AMPrO-3D/Roboterarm/Warenkorb/README.md

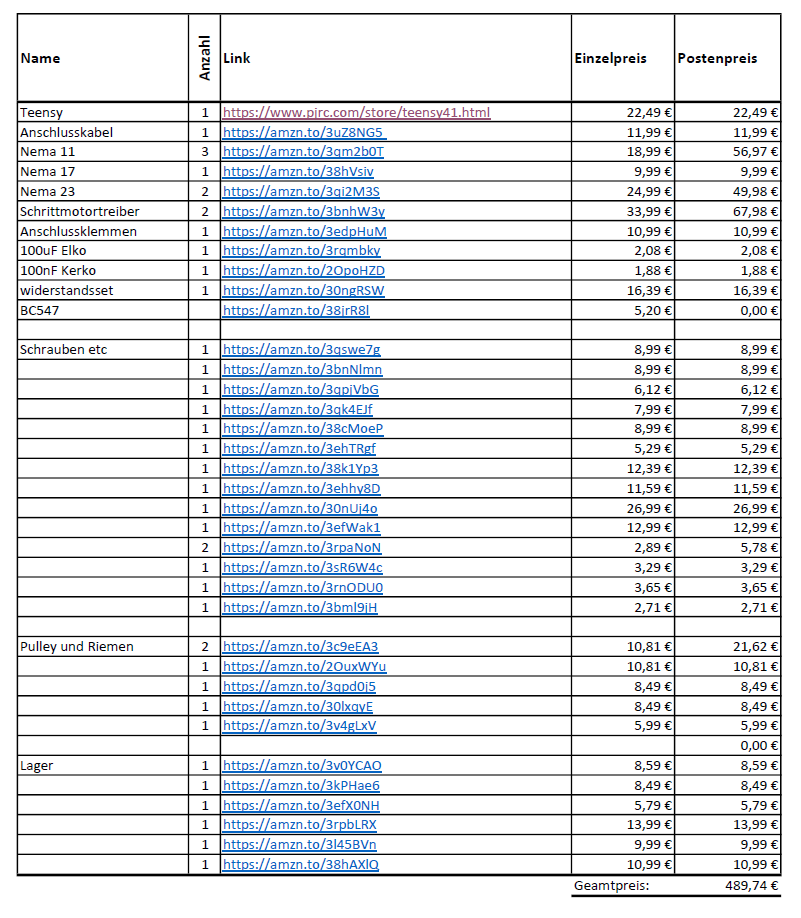
[picture p7: blob/Bilder/Warenkorb.PNG]
Board Preview
