AMPrO-3D/Roboterarm/Elektronik/README.md

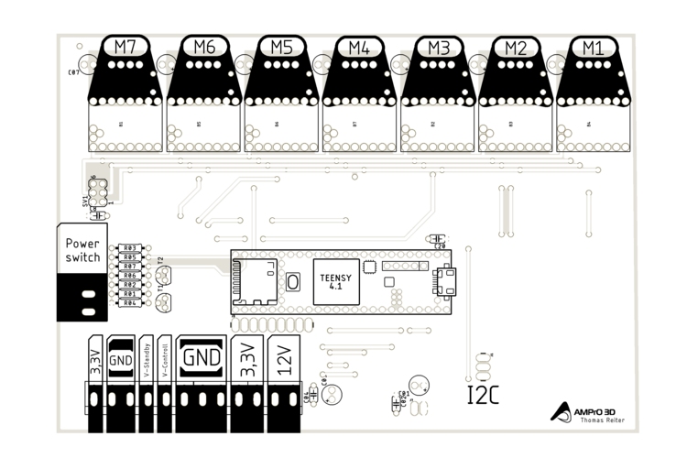
[picture p8: blob/Bilder/MainBoard.png]
Board Preview

Board Preview
