AMPrO-3D/Roboterarm/Firmware/README.md

# HowTo
<hr>

Um die Firmware auf den Teensy zu Flashen, wird zum einen die Arduino IDE benötigt, die unter folgendem Link heruntergeladen werden kann: <br>
https://www.arduino.cc/en/software <br>
sowie das Addon Teensyduino, welches über folgende Webseite heruntergeladen und installiert werden kann: <br>
https://www.pjrc.com/teensy/teensyduino.html

### Als Erstes lädt man die Firmware in die Arduino Entwicklungsumgebung.
### Anschließend muss über "Werkzeuge" unter "Board" die Option "Teensy 4.1" ausgewählt werden

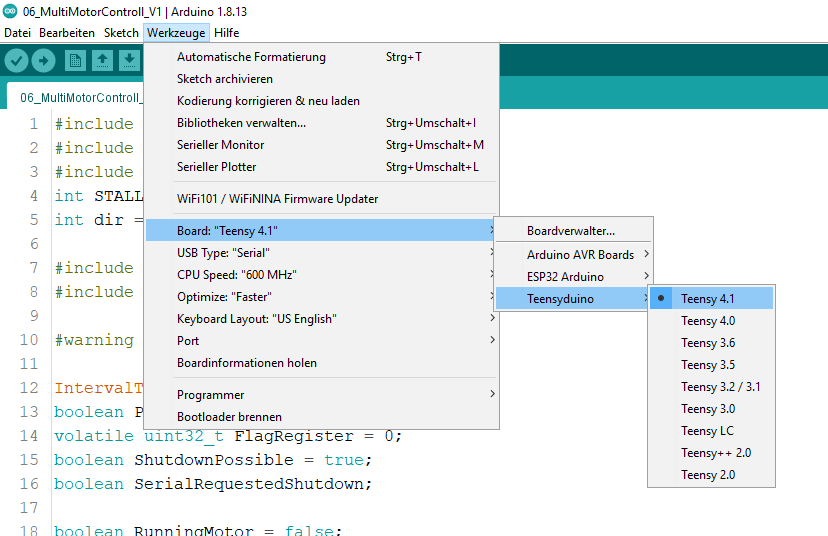
[picture p9: blob/Bilder/ArduinoIDEA1.png]
Arduino Settings
⋅⋅⋅
<br>
<br>
<br>
<br>
### Wenn man nun über "Werkzeuge" unter "Port" den Eintrag auswählt der mit "Serial (Teensy 4.1)" endet

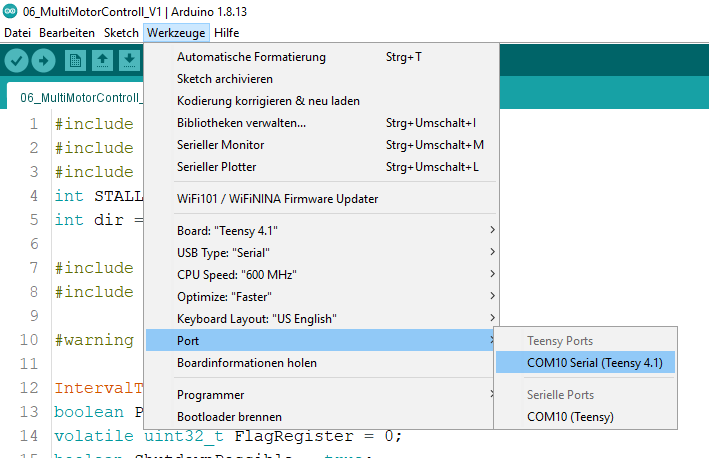
[picture p10: blob/Bilder/ArduinoIDEA2.png]
Arduino Settings
⋅⋅⋅
<br>
<br>
<br>
<br>
### kann man über "Sketch" auf "Hochladen" klicken, um die Firmware auf den Teensy zu flashen

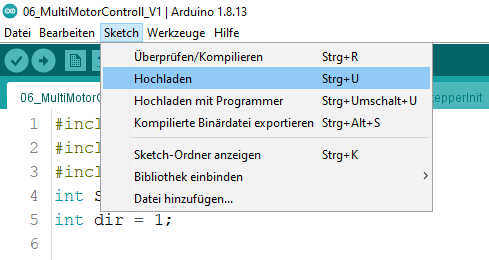
[picture p11: blob/Bilder/ArduinoIDEA3.png]
Arduino Settings
⋅⋅⋅
