AMPrO-3D/Roboterarm/Zusatzteile/Greifer/README.md

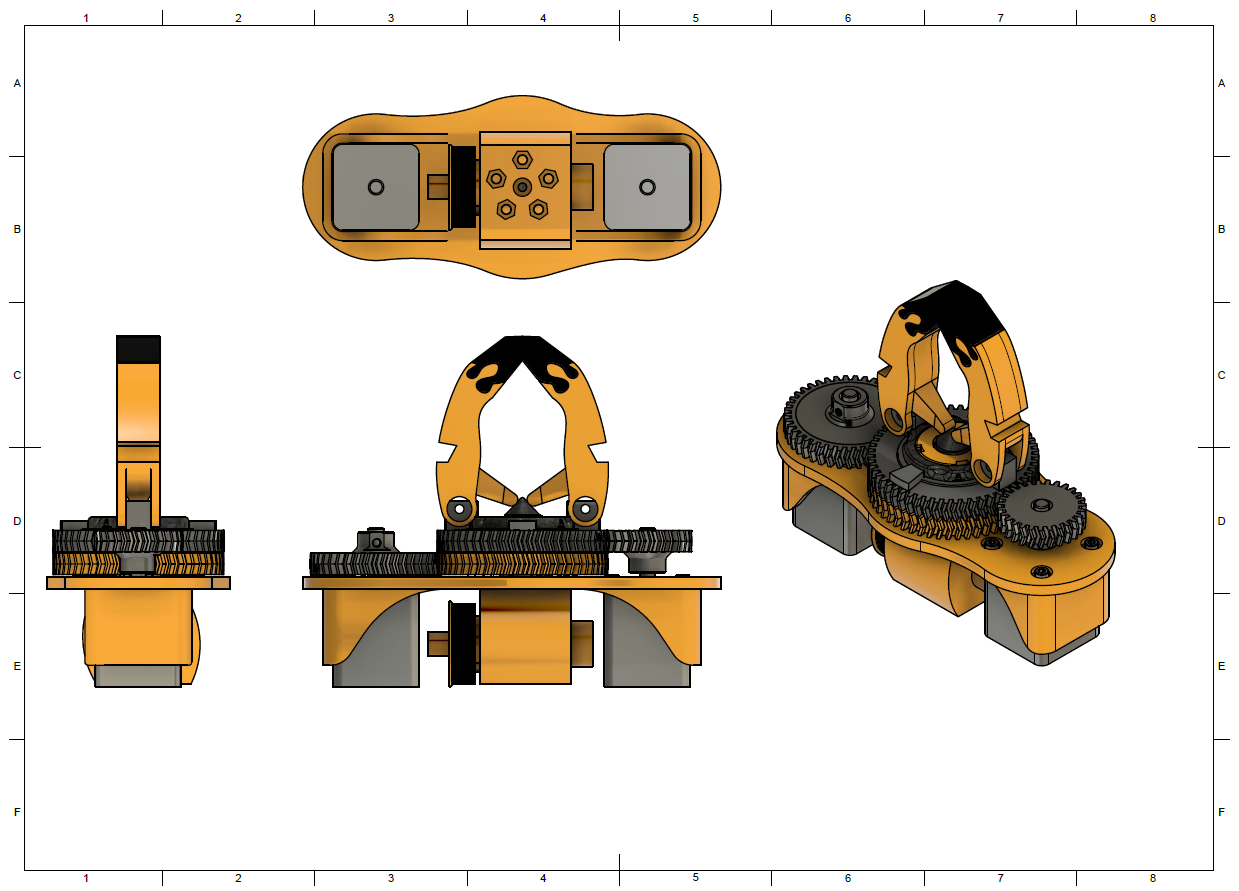
[picture p12: blob/Bilder/GreiferB1.PNG]
Greifer Preview

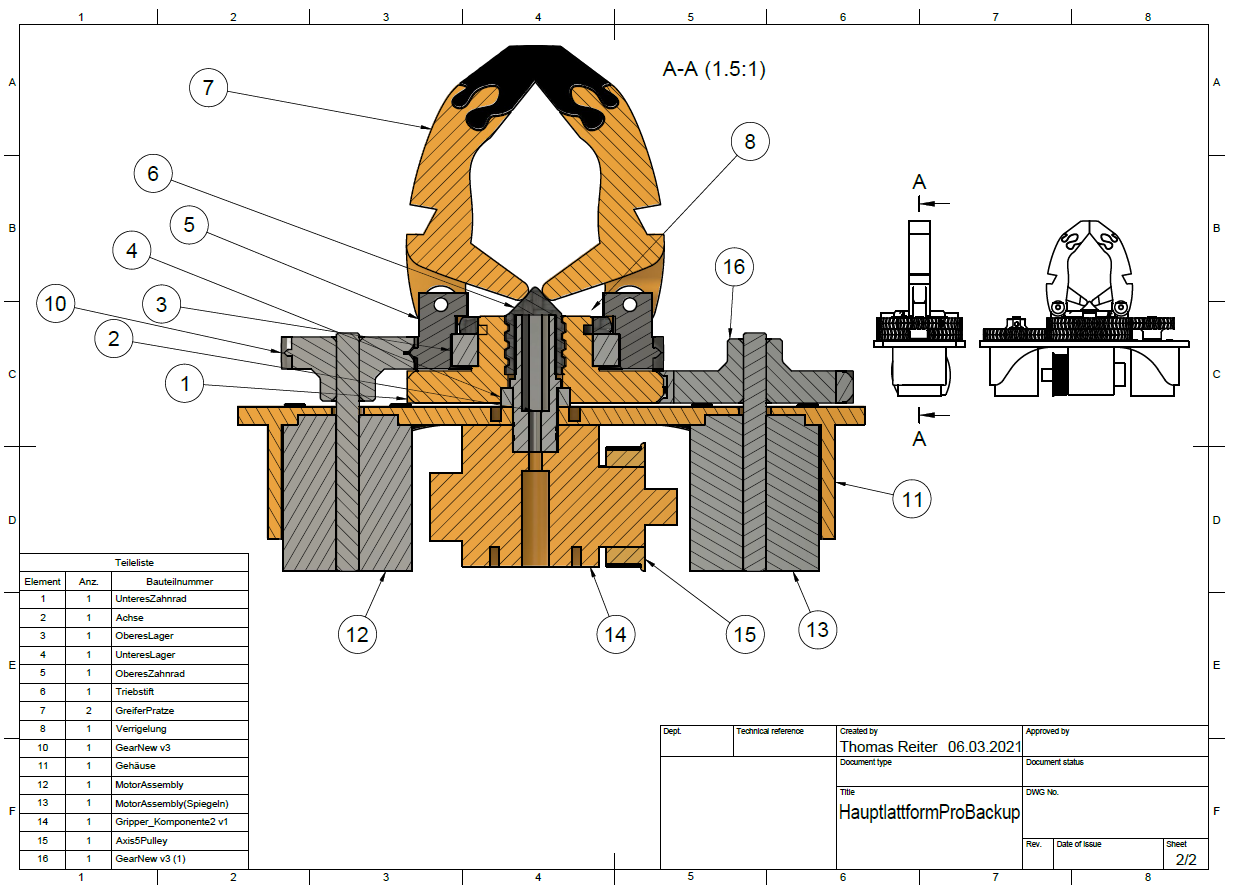
[picture p13: blob/Bilder/GreiferB2.PNG]
Greifer Preview
