AMPrO-3D/Roboterarm/Zusatzteile/Axis1Pulley_OpenLoop.stl

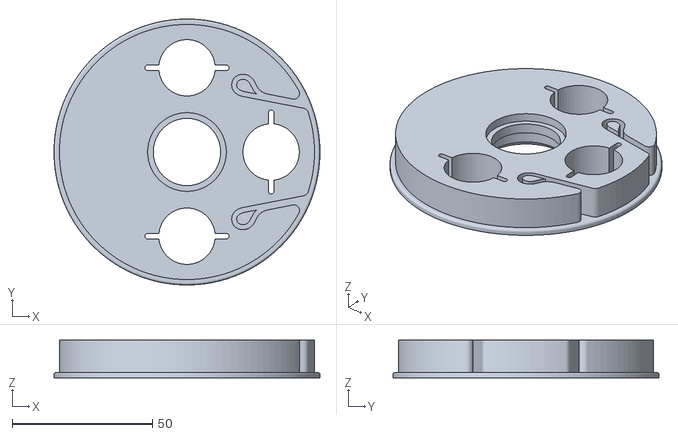
[picture p14: CAD file, 2021-04-03]
Zusatzteile/Axis1Pulley_OpenLoop.stl
94.8 x 94.8 x 13.5
