AMPrO-3D/Roboterarm/Zusatzteile/Greifer/Motorhalterung.stl

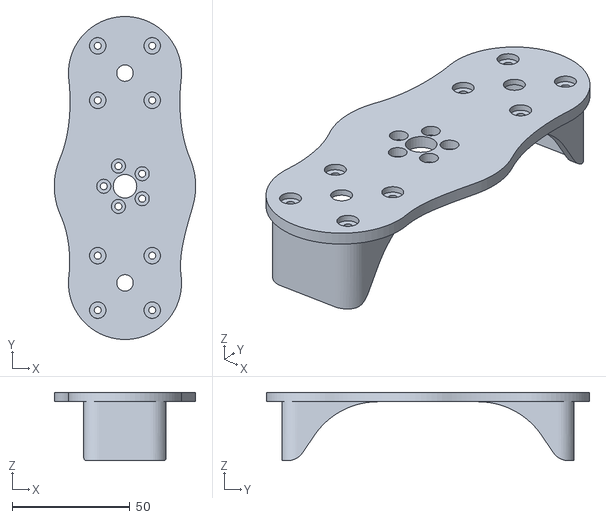
[picture p15: CAD file, 2021-03-06]
Zusatzteile/Greifer/Motorhalterung.stl
60.0 x 137.0 x 29.0
