AMPrO-3D/Roboterarm/Zusatzteile/Axis2Pulley_OpenLoop.stl

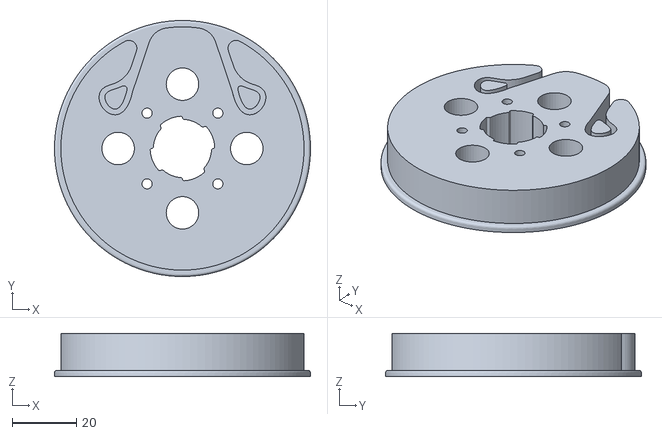
[picture p16: CAD file, 2021-04-03]
Zusatzteile/Axis2Pulley_OpenLoop.stl
79.6 x 79.6 x 13.5
