AMPrO-3D/Roboterarm/Zusatzteile/Greifer/Achse.stl

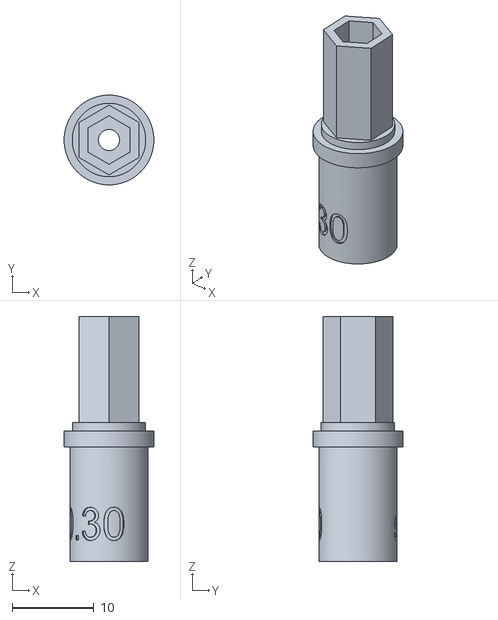
[picture p17: CAD file, 2021-03-06]
Zusatzteile/Greifer/Achse.stl
11.0 x 11.0 x 30.0
