AMPrO-3D/Roboterarm/Zusatzteile/Greifer/Triebstift.stl

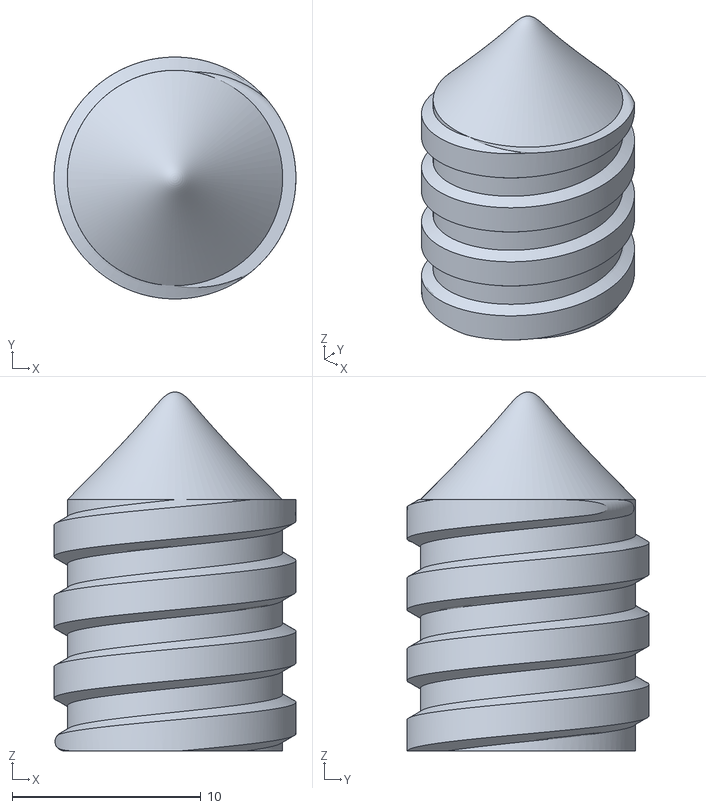
[picture p18: CAD file, 2021-03-06]
Zusatzteile/Greifer/Triebstift.stl
12.8 x 12.8 x 19.0
