AMPrO-3D/Roboterarm/Zusatzteile/Standoff.stl

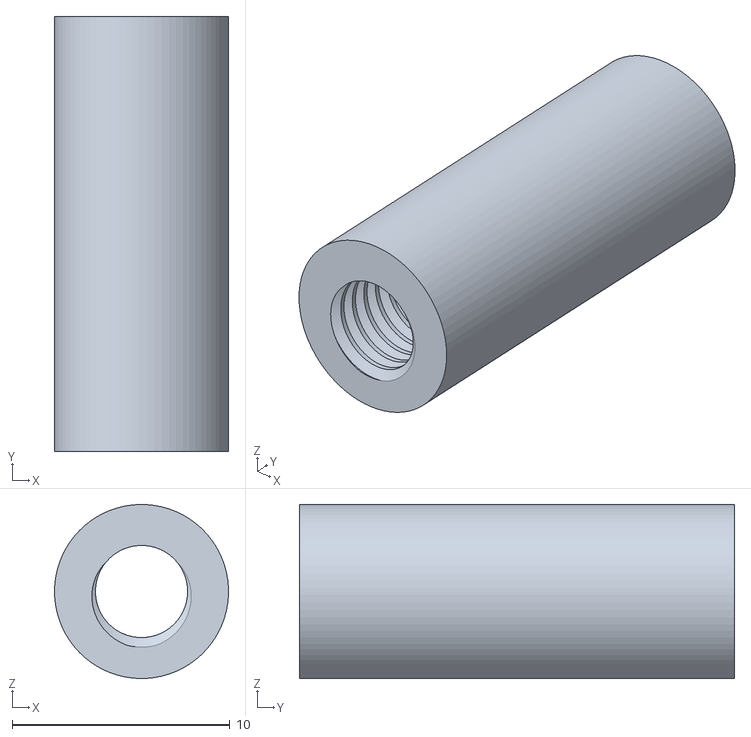
[picture p19: CAD file, 2021-03-06]
Zusatzteile/Standoff.stl
8.00 x 20.0 x 8.00
