AMPrO-3D/Roboterarm/Zusatzteile/Greifer/Verrigelung.stl

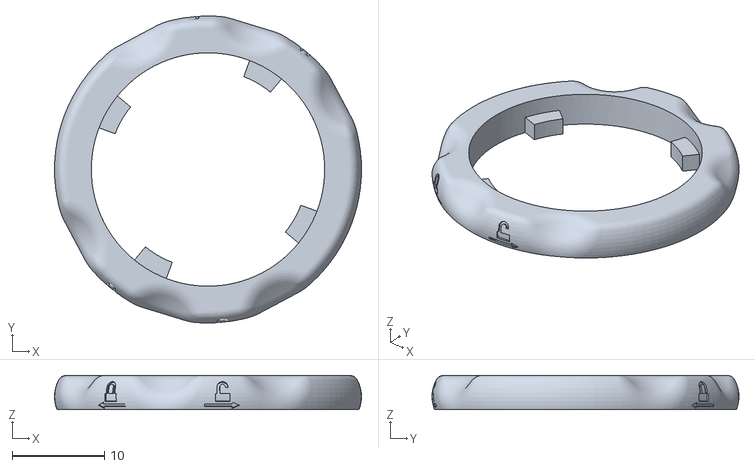
[picture p20: CAD file, 2021-03-06]
Zusatzteile/Greifer/Verrigelung.stl
33.2 x 33.2 x 3.72
