AMPrO-3D/Roboterarm/Zusatzteile/Greifer/Basiselement.stl

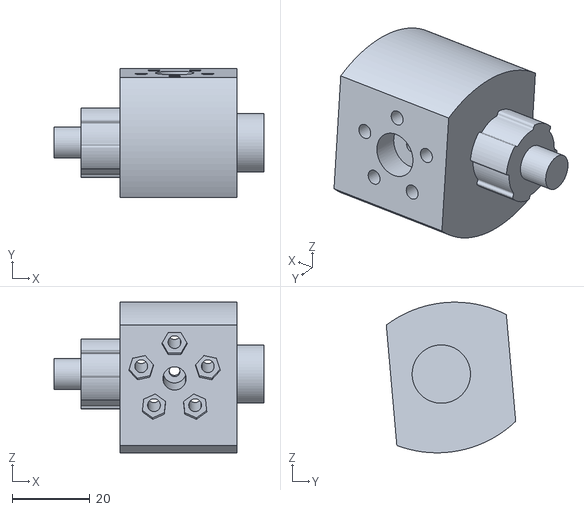
[picture p21: CAD file, 2021-03-06]
Zusatzteile/Greifer/Basiselement.stl
54.0 x 33.3 x 38.7
