AMPrO-3D/Roboterarm/Zusatzteile/Greifer/GreiferPratze_2mal.stl

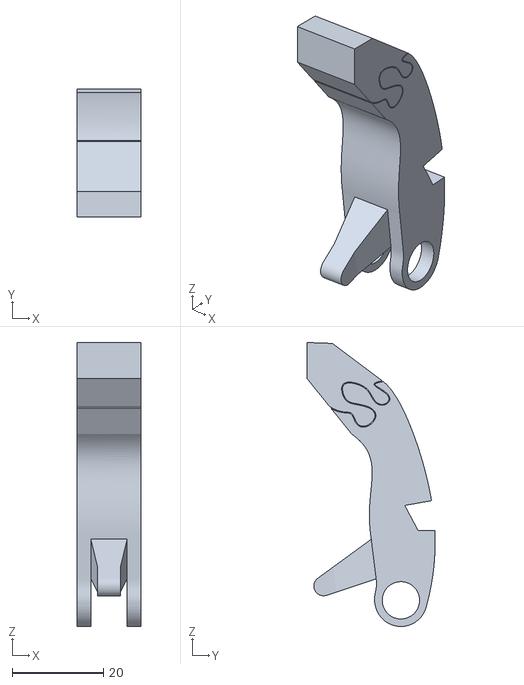
[picture p22: CAD file, 2021-03-06]
Zusatzteile/Greifer/GreiferPratze_2mal.stl
14.0 x 28.2 x 62.4
