AMPrO-3D/Roboterarm/(threads)

Thread 2 (2021-03-08):

3D-Druck Automatische Teileentnahme

chris3Dtec, 2021-03-08:
Hallo ich bin der Chris
Bin Total begeistert von dem Roboterarm, ich wurde drauf hingewiesen hier mein Vorhaben mit euch zu teilen was ich mit dem Roboterarm vorhaben würde.

Also ich Drucke verschiedene Adapter in einer hohen Stückzahl aus für meinen Kunden und meist ist es so das ich immer von einen Adapter ein paar 100 Stück brauche, da würde sich der Roboterarm zur automatischen Teileentnahme sehr gut anbieten weil es ja auch immer das gleiche Bauteil ist und der Code auch der gleiche wäre außer ich Drucke einen anderen Adapter der dicker ist aber da müsste man den Code einfach ändern damit sich der Greifarm auf die dicke des Adapters richtet.

Danke für das tolle Projekt, ich würde euch auch gerne Unterstützen.

Lg Chris

AMPrO-3D, 2021-03-08:
Die Firmware ist aktuell darauf ausgelegt, manuell angesteuert zu werden. Die Firmware ist in dem Sinne mehr oder weniger „dumm“ und führt nur aus, was man ihr per USB an Befehlen gibt.
Das kann man aber ändern und wäre auch nicht unendlich viel Aufwand. Dabei helfe ich dir und den anderen die das versuchen auch gerne. (Laut den Kommentaren haben das doch einige vor)
Wo man dann aber schauen muss, ist ob der Roboter ausreichend Kraft hat, ein 3D-Druck Objekt von der Druckplattform zunehmen. Der Roboterarm ist darauf ausgelegt, nicht gefährlich zu sein, damit man ohne große Gefährdung mit Ihm „spielen“ kann. Eigentlich sollten alle Achsen in Schrittverluste Fahren, sobald irgendwo ein Finger drin ist.
**→ Was nicht bedeutet das man das ausprobieren sollte!**
Der Greifer selber hat nur soviel Kraft, wie der Gummi der den Greifer schließt, weil der Antriebsmotor den Greifer nur auffahren kann. Insgesamt hat der Kopf sehr wenig Kraft, da mit steigender Kraft auch steigendes Gewicht einhergeht. Je schwerer der Kopf ist, desto mehr Kraft brauchen die anderen Achsen, die diesen Kopf bewegen müssen.
Je nachdem wie stark die Betthaftung ist, zweifle ich daher stark daran, das der Roboter geschweige der Greifer in der Lage ist ein Druckteil von einem Druckteil zu reißen.
Was aber durchaus vorstellbar wäre, ist das der Extruder selber gegen das Druckteil rammt, was das Druckteil von der Plattform reißen sollte. Wurde inzwischen schon mehrfach in anderen YouTube Videos gezeigt.
Wenn das Druckteil abgelöst ist, Sollte der Roboterarm, dieses aber wegnehmen und einsortieren können.
Da das Druckteil dann aber nicht mehr an einer definierten Stelle liegt, könnte es sinnvoll sein, mithilfe einer Kamera die ungefähre Position des Bauteils zu ermitteln, um es dann vom Roboterarm aufheben zu lassen.
Als Schnittstellen stehen hierfür einmal I²C sowie USB, als auch ein 9 Pin GPIO Header zur Verfügung.

Thread 4 (2021-03-10):

3d scan mit zwei scan systemen

0Snov, 2021-03-10:
Kombinieren zweier Scansysteme ( LiDar/ Streifen-Scan ( als Beispiel ) ) mit einen DIY Robby.
Da im heimischen Bereich die Ressourcen oft begrenzt sind und die Scan-Geräte die auf dem Markt sind nie das erreichen was man gerne selber scanen möchte ( sei es durch die Oberfläche oder der Form ) .
Liegt es nahe, sich dieses mithilfe der vorhandenen aktuellen Mittel dieses selber zu generieren.

1. Roboter mit 6 Achsen ( DIY ... anderers Projekt  erledigt )
2. Streifen Scaner ist erhältlich ( doch nicht erschwinglich )
3. Linienlaser  ist erhältlich ( doch nicht für alle Formen zum scanen geeignet )
4. Kamera sind viele auf dem Markt mit ausreichender Auflösung
5. Softwartechnisch ist das ganze immer noch in Einzelteilen ( Photogrammetrie, Bereinigung der Bilder und  Umwandlung in
    Druckbare Dateien )

Eine Idee:
Zwei Scans nacheinander des selben Objektes mit je einer anderen Methode.
Erster Scan    --> grober Scan des Objektes als Fixierung
Zweiter Scan  --> fein Scan mit ( so ziehmlich ) allen Details
Die Software legt beide Scans übereinander und filtert überflüssige Punkte ( aus der Punktewolke ) heraus.
Legt dann ein druck fähige Datei ab. ( Passend zu den Einzelnen Druckern  ( wegen Bauraumgröße  x y z )

Und siehe da wir haben eine EierlegendeWollmilchSau für den Heimanwender...

Thread 5 (2021-04-02):

Element 3 'Oberes Lager' & Element 4 'Unteres Lager'

RalfD62, 2021-04-02:
Hallo Thomas,

bin gerade dabei die Einzelteile für den Greiferarm zu drucken. Bei der Montage sehe ich in der Stückliste 2 Lager (Element 3 + 4) aufgeführt, die ich in der Warenliste nicht finden kann. Könntest Du mir bitte Auskunft darüber geben, welche Art von Rollenlager dort Verwendung finden.

Besten Dank im Voraus

AMPrO-3D, 2021-04-02:
Hallo Ralf,

bitte entschuldige, da ist mir ein Fehler unterlaufen.

Das hier sind die Links zu den beiden Lagern:

https://www.amazon.de/Kugellager-6805-2RS-versiegelte-Rillenkugellager-Außendurchmesser/dp/B07RLXCZJH/ref=pd_ybh_a_2?_encoding=UTF8&psc=1&refRID=0TCZ51XADYC667T9YV54

https://www.amazon.de/Kugellager-10x15x4mm-Doppelt-Geschirmt-D%C3%BCnnwandige/dp/B07M9VVSW3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

Die beiden Zahnräder "ZahnradGross" und "ZahnradKlein" sind in der Stückliste unter der Teilenummer 10 und 16 zu finden. Wurden nur beim Export umbenannt.

Mit 11 ist die große Platte gemeint, an der die Motoren verschraubt und der Greifer montiert wird, mit 12 ist eine Motoreinheit gemeint.

Und die Datei Standoff.stl wir dafür verwendet, um  die beiden Grundplatten auf Abstand zuhalten und die Beine daran zu montieren. Im Original wurden hier einfach Metallgewindeelemente verwendet (siehe Anleitung von Skyentific)

RalfD62, 2021-04-02:
Hallo Thomas,

besten Dank für den prompten Service. Dann komme ich mechanisch schon mal eine Ecke weiter.

Wünsche ein frohes Osterfest

Mit freundlichem Gruß

Ralf Droste

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

Alexxx2005, 2021-04-02:
Hallo Ralf,

wo finde ich eine Zusammenbauzeichnung ?

Schöne Ostern @all

Grüße Alex

AMPrO-3D, 2021-04-03:
@RalfD62 Meinst du von dem gesamten Roboter? Da bitte einfach die Videos von Skyentific anschauen und seine Dokumente verwenden. Da habe ich nur die beiden Pulleys abgeändert, sodass man GT2 Pulleys für die Motoren hernehmen kann, und dann einen offenen Riemen in dem Pulley verspannen kann. Hier kann übrigens etwas Klebstoff zusätzlich hilfreich sein

RalfD62, 2021-04-03:
@

> @RalfD62 Meinst du von dem gesamten Roboter? Da bitte einfach die Videos von Skyentific anschauen und seine Dokumente verwenden. Da habe ich nur die beiden Pulleys abgeändert, sodass man GT2 Pulleys für die Motoren hernehmen kann, und dann einen offenen Riemen in dem Pulley verspannen kann. Hier kann übrigens etwas Klebstoff zusätzlich hilfreich sein

Guten Morgen @AMPrO-3D ,

Die Montage der einzelnen Armelemente von Skyentific habe ich verstanden. Es ging lediglich um die hier im Github von Dir beigefügte technische Zeichnung des Greiferarms. Aber Du hast mir da schon ein großes Stück weitergeholfen. Nun wird erstmal fleißig gedruckt.

Schönes Osterfest @ALL

RalfD62, 2021-04-03:
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

Guten Morgen @Alexxx2005,

die technische Zeichnung zum Greifer findest Du hier im Github unter Roboterarm/Zusatzteile/Greifer/. Den kompletten Zusammenbau des restlichen Roboters von Skyentific findest Du nur auf Youtube als Videoanleitungen:

Teil1: https://www.youtube.com/watch?v=oFCUw1pXlnA
Teil2: https://www.youtube.com/watch?v=-_JlGpFUsqo
Teil3: https://www.youtube.com/watch?v=12Be3Hoh-sY
Teil4: https://www.youtube.com/watch?v=PM_dLoU60yY&t=444s
Teil5: https://www.youtube.com/watch?v=Citiq6Zfdu4&t=822s
Teil6: https://www.youtube.com/watch?v=WnI4xxdUh2k&t=558s

Teil 7: https://www.youtube.com/watch?v=BsTtLztRnVI&t=79s

Wünsche ein schönes Osterfest

Ralf

Thread 6 (2021-04-14):

Widersänder?

elektrofreak86, 2021-04-14:
Hallo AMPrO 3D Team,

Ich hätte da mal ein paar Fragen.
ich habe den Roboterarm jetzt Fertig augebaut und Heute die Platine Version 1 gefräst, mir ist aufgefallen das es zur ersten Platinen Version keine Stückliste zu den Widerständen R1 - R7 gibt, welche Wiederstände sind dort eingesetzt?
Gibt es noch einen Beschreibung zu den Pins SV1?
Was hat sich in Version 1 zu 2 in der Platine und Funktion Geändert? Mir ist nur die Geänderte Widerstandsschaltung aufgefallen.
Und kann es sein das in der Version 2 der Emitter Anschluss von T1 an die Widerstände fehlt?
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

Sven

AMPrO-3D, 2021-04-14:
Oh Nein.... F** Da ist mir ein Fehler unterlaufen... Ja das sollte eigentlich verbunden sein :-( Danke für den Hinweis!

Geändert hat sich, dass ich in der alten Version einen Fehler gebaut habe, den ich dann auf der Platine, die der Andi hat, manuell ausgebessert habe. Das habe ich leider vergessen beim Upload dieses Repos, und daher die unveränderte Version hochgeladen, die diesen Fehler hat. Die Version 2 hat ein Lochrasterfeld in dem Leeren Bereich auf der rechten Seite, damit man für eigene Basteleien gleich was zum Löten hat.  Und wie gesagt besagter Fehler wurde ausgebessert. Die Bestückung der Widerstände kann aus den Eagle Files abgelesen werden, ich mach aber gleich noch eine Teileliste, das ist wahrscheinlich praktischer...

AMPrO-3D, 2021-04-14:
Also ich habe den Fehler schnell herausgemacht und neu hochgeladen. Nun aber zu deiner Platine. Auf diesem Bild kannst du sehen, wie ich den ursprünglichen Fehler auf der Platine "raus gepfuscht habe"
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

elektrofreak86, 2021-04-14:
Okay dann ändere ich das bei mir noch ab, was noch interessant  wäre ist der jumper SV1, gibt es da was zu beachten? Welche Funktion hat der?

AMPrO-3D, 2021-04-14:
Dieser Header führt den SPI über den die Treiber angesteuert werden. Dies dient eigentlich nur zu Fehlersuche, kann aber auch für zusätzliche Peripherie genutzt werden. Die Treiber hätten auch die Möglichkeit, mittels Stallguard die Mechanischen Endanschläge zu erkennen. Das haben wir dann aber bleiben lassen, weil das Zeitlich nicht mehr machbar gewesen wäre, kann aber auch über diesen Header abgefragt werden.

Thread 7 (2021-04-16):

MotionController

elektrofreak86, 2021-04-16:
Hallo,

Hab Die Hardware vom Robotorarm Fertig das Programm ist auf den Teensy 4.1 geschrieben, wenn ich den USB Stecken einstecke werde die Schrittmotoren unter Strom Gesetzt, bis dahin ist alles Super.

Jetzt habe ich den MotionController gestartet und komme damit leider nicht zurecht.

Vermutte das man über das untere Menü den Ablauf der 7 Achse Einrichtet, doch sobalt ich auf "Verbinde mit MotionController" klicke Stürzt dasProgramm ab und erstellt diese Log Datei

[hs_err_pid9040.log](https://github.com/AMPrO-3D/Roboterarm/files/6326289/hs_err_pid9040.log)

Wofür sind die Blauen Schiebregler auf der Rechten Seite?

Einen Spacemous besitzte ich leider nicht, aber dafür einen Xbox Kontroller der am PC Angeschlossen ist wäre es auch möglich diesen zu verwenden?

Gruß

Sven

AMPrO-3D, 2021-04-16:
Die blauen Schieberegler, sind die manuelle Ansteuerung der Achsen des Roboters, der Bereich unten im Fenster zusammen mit dem Bereich auf der linken Seite oben im Fenster dienen dazu, den Roboter definierte Bewegungsabläufe abzufahren. Diese Bewegungsabläufe sind auf ein festes Zeitfenster beschränkt. Im Bereich unten kannst du pro Zeile Keyframes hinzufügen. Jedes dieser Grauen Kästchen kann zwei Zustände besitzen: "void" und "point" Die Timeline muss immer so aufgebaut sein, dass sie mit einem Point beginnt und mit einem Point aufhört. Dazwischen müssen sich Point und Void immer Abwechseln. Es dürfen also niemals zwei Points aneinander anliegen, und auch nie zwei voids aneinander anliegen.  Du kannst mit den Pfeiltasten in der Timeline navigieren. Ein Ausgewähltes Kästchen bekommt einen roten Rahmen. Ist aktuell ein Point ausgewählt, kannst du über den Slider, der dann  in der Mitte des Bildschirms wählbar wird, die Höhe des Points definieren. Der Roboter bewegt sich also von Point zu Point, und die Voids definieren den Übergang zwischen zwei Points. Wählst du eine Void aus, erscheinen im oberen Bereich des Fensters an der entsprechenden Linie zwei graue Kreise, an diesen Kreisen kannst du die Linie verformen, das Prinzip ähnelt Splines in Konstruktionsprogrammen. Die Software ist bei weitem nicht ausgereift, ist voller Bugs und definitiv eine Frage der Geduld. Mit ein bisschen Geschick sollte es aber jeder hinbekommen.  Über die Buttons unten rechts aktiviert die Software die Verbindung zum entsprechenden Partner. Der Button für den SpaceNavigator sorgt aktuell für ein Aufhängen der Software, wenn er betätigt wird, ohne das ein SpaceNavigator angeschlossen ist.

Aktuell ist noch kein Interface für ein Gamepad integriert, das kann aber hinzugefügt werden. Aktuell fehlt mir dazu die Zeit, wie auch zu allen anderen Ausbesserungen der Software, weshalb sie seit Videoupload nicht mehr verbessert wurde. Das steht definitiv an, ich kann aber nicht sagen, wann ich dazu komme.

Der Motion Controller kann übrigens auch über den seriellen Monitor der Arduino IDE angesteuert werden. Hierfür den seriellen Monitor öffnen und mit den Achsen A bis G die einzelnen Roboter Achsen ansprechen. Bsp A1000
oder G-100 hier einfach ein bisschen herumspielen.

Um das Problem mit deinem Fehler zu fixen, brauche ich mehr Zeit, das schaffe ich heute nicht mehr

elektrofreak86, 2021-04-17:
Okay, für die ersten Test bewegungen hat das mit dem seriellen Monitor sehr gut funktioniert.

elektrofreak86, 2021-05-13:
Hallo

gibt es was neues über den MonitionController, habe es Nochmal mit einem anderen Comptuer versucht doch leider stürtzt der MotionController direkt ab sobald ich auf "Verbinde mit MotionController" klicke.

elektrofreak86, 2021-06-29:
Hallo,

Hat jemand schon erfahrung mit dem MonitionController, ich habe keinen SpaceNavigator und bei "Verbinden mit MotionController" Stürzt das programm ab. Würde es gerne mit einen Gamepad Verbinden oder änlichem. Hat das jemand schon irgendwie zum laufen gebracht?

UweR55, 2021-07-13:
Hallo Sven, gute Idee vom Thomas.
Wenn er uns einen Termin nennt, wäre super
Vielleicht kommen wir  ja dann weiter
Gruß Uwe

elektrofreak86, 2021-07-13:
Hallo Uwe,

Ja finde das auch eine gut idee

Gruß

Sven

Gesendet: Dienstag, 13. Juli 2021 um 19:14 Uhr
Von: "UweR55" ***@***.***>
An: "AMPrO-3D/Roboterarm" ***@***.***>
Cc: "elektrofreak86" ***@***.***>, "Author" ***@***.***>
Betreff: Re: [AMPrO-3D/Roboterarm] MotionController (#7)

Hallo Sven, gute Idee vom Thomas.
Wenn er uns einen Termin nennt, wäre super
Vielleicht kommen wir ja dann weiter
Gruß Uwe

—
You are receiving this because you authored the thread.
Reply to this email directly, view it on GitHub, or unsubscribe.

UweR55, 2021-07-14:
Guten Morgen Sven,
wir könnten ja mal telefonieren.
Was hälst Du davon?
Gruß Uwe

elektrofreak86, 2021-07-15:
Hallo UweDas können wir gerne machenHier meine Nummer015112291125Gruß Sven--Diese Nachricht wurde von meinem Android Mobiltelefon mit GMX Mail gesendet.Am 14.07.21, 12:11 schrieb UweR55 ***@***.***>:

  Guten Morgen Sven, wir könnten ja mal telefonieren. Was hälst Du davon? Gruß Uwe
  —You are receiving this because you authored the thread.Reply to this email directly, view it on GitHub, or unsubscribe.

UweR55, 2021-07-16:
Morgen Sven, meine Nummer  01575 4249088
Meine Mail Adresse   riesuwe55@mail.com   ==>  kannst mich auch direkt anschreiben
Gruß Uwe

UweR55, 2021-07-16:
Ich hatte hinsichtlich eines Termins für das Zoom Meeting mit dem Thomas nächste Woche den Montag oder Dienstag (also der 19.07 bzw. 20.07 vorgeschlagen, so ab 18:30Uhr, rufe Dich heute Abend mal an, können dann Details klären
Gruß Uwe

JoergD66, 2022-01-31:
Hallo  zusammen, gibt es was neues zum Motion Controller? Bei mir läuft er soweit, ich habe auch eine SpaceMouse von 3DConnexion allerdings als Wireless Version. Ich habe sie dann über USB angeschlossen. Sobald ich dann aber auf verbinden mit Space Navigator klicke Stürzt der Motion Controller auch ab. Liegt es daran, dass es die Wireless Version der SpaceMouse ist.
Würde mich freuen wenn es ähnliche Erfahrungen bei Euch gibt.
Gruß Jörg

UweR55, 2022-01-31:
Hallo Jörg, ich muss leider 3 Baugruppen neu drucken; durch ein Fehler auf
der Platine hatten sich die Motoren so schnell erhitzt, das sich die 3
Bauteile stark verform hatten.
Sehr ärgerlich, da ich ja komplett alles verkabelt hatte.  Es muss alles
auseinander. Zur Zeit ist mein Drucker in Reparatur, also es geht nichts :((
Gruß Uwe

JoergD66 ***@***.***> schrieb am Mo., 31. Jan. 2022, 11:02:

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

JoergD66, 2022-01-31:
Hallo Uwe, Danke für die schnelle Rückmeldung.
Das ist übel mit der Verkabelung!!!
Währe super wenn du an dem Programm dran bleibst.

Wünsche noch viel Erfolg bei der Rep. des  Druckers und dem zerlegen den Arms!!!
Gruß Jörg

UweR55, 2022-01-31:
Hallo Jörg,
bleiben in Verbindung.
Alles Gute

JoergD66 ***@***.***> schrieb am Mo., 31. Jan. 2022, 16:08:

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

JoeBerlin69, 2022-02-17:
Hallo,
ich habe zwei kleinere Probleme mit dem MotionController.
Die Ansteuerung über die blauen Schieberegler funktioniert anstandslos.

1. Die Anfangs gepostete Erklärung verstehe ich leider nicht. Vor allem den Teil mit Void/Void Point /point und dem Schiebregler von 0-255. Ich würde gerne eine Bewegung wie ein Makro aufnehmen und speichern können.
2. Ich habe eine 3dconnexion SpaceMouseCompact. Ist die kompatibel mit SpaceNavigator. Funktionieren tut sie mit dem MotionController leider nicht.

Thread 8 (2021-06-06):

Mainboard und Bestückung

UweR55, 2021-06-06:
Hallo Thomas, danke für den Schaltplan :))

Ich habe noch ein Problem und zwar auf dem Schaltplan Rev3 vom 14.04.2021 sind **6 Widerstände** abgebildet mit den entsprechenden Werten.
Auf der Platine die ich habe ätzen lassen, werden aber **7 Widerstände** benötigt. Und zwar **fehlt dann der Widerstandswert
für den R03**.  Frage: Kann ich alle Werte aus dem Schaltplan Rev3 vom 14.04.2021 18:16  übernehmen für meine Platine und
für den fehlenden Widerstand R03 den Wert vom R04= 8,2KOhm; R03 u. R04 gehen ja beide an die **Basis** von den Transistoren BC547.  Wenn das nicht möglich ist, brauchte ich für R03 einen aktuellen Wert.

Frage 2:  Kann ich den Teensy 4.1 mittels Mini USB außerhalb der Platine programmieren??
Frage 3: Muss ich alle Stromanschlüsse 3,3V ( 3x ) und 12V (2x) bzw GND (5x)  auf der Platine mittels ATX Netzteil für einen Test belegen??
Frage 4: Was muss an den Eingang **Power switch**? oder muss der nicht zwingend belegt werden ?
Danke und Gruß Uwe R.

AMPrO-3D, 2021-06-09:
Hallo Uwe,

erstmal sorry, dass sich meine Antworten immer so ziehen, bei uns ist grad viel los...

zu deiner Frage 1:

Du hast dir die Platine nach der Rev1 Fertigen lassen. In diesem Layout waren Fehler, welche ich durch Rev2 und Rev3 ausgebessert habe. Macht aber nix, die Fehler kannst du auch mit deiner Bestehenden Platine ausbessern. Den Schaltplan den ich erstellt habe, ist für die Rev3. Der Schaltplan für deine Platine habe ich gerade im Elektronik-Ordner eingefügt. Dort kannst du auch die Widerstandswerte finden die zu den Bauteilenamen im Silk auf deiner Platine passen.

zu Frage 2:

Der Teensy hat einen USB-Micro Anschluss. Wenn du einen entsprechenden Adapter findest, kannst du ihn aber auch über USB-Mini Flashen, Dabei solltest du aber etwas aufpassen, weil der Micro-USB Anschluss einen HOST-Pin hat, über den Festgelegt wird ob Spannung vom oder zum Gerät geliefert wird. Du solltest daher acht geben, das dein Adapter KEIN OTG-Adapter ist, der würde dann nämlich nicht funktionieren

zu Frage 3:
Ja genau, so wärs gedacht. Also den Stecker des ATX-Netzteils abzwicken, und und die Adern auf die ensprechenden Pads der Platine auflegen. Wir haben dafür Steckbare Schraubsockel verwendet, das macht es komfortabler

zu Frage 4:
werden die beiden Anschlüsse kurzgeschlossen, so schaltet der Teensy das ATX-Netzteil aus, wodurch die Motoren Spannungsfrei sind. Wenn kein PC per USB angeschlossen ist, dann geht der ganze Roboter dabei aus, sonst nur die Motorendstufen/Treiber. Der MUSS nicht belegt sein, kann aber

AMPrO-3D, 2021-06-09:
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

Der Transistor T2 fällt komplett weg, daher kannst du R3 auch weg lassen (der Grund, warum bei dir ein Widerstand mehr auf dem Layout ist als bei Rev3) Der Linke Anschluss von R04 sollte aus dem Pad der Platine gezogen sein und stattdessen mit dem Linken Pin des ehemaligen R03 verbunden sein.

in Kurz:

R3 und T2 raus, R4 nur rechts anlöten, den anderen Anschluss des Widerstands mit dem linken Lötauge von dem Leeren R3 Platz anlöten

UweR55, 2021-06-09:
Hallo Thomas, werde das wie beschrieben in Angriff nehmen.
Danke und Gruß

Am Mi., 9. Juni 2021 um 20:45 Uhr schrieb AMPrO 3D ***@***.***
>:

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

UweR55, 2021-06-10:
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

Hallo Thomas, passt das so?

AMPrO-3D, 2021-06-10:
Schaut gut aus. im am besten, bevor du das ganze in betrieb nimmst, schließ nur das ATX netzteil an, und keine Treiber und keinen Teensy. Und dann schau ob das ATX-Netzteil angeht, wenn du V-Standby mit dem Pin links oben am Teensysockel verbindest.

UweR55, 2021-06-11:
Morgen Thomas, wenn es Dir nicht zu viel Mühe macht, könntest mir eine kleine Handskizze hochladen mit dem vorgehen ATX Netzteil und V - Standby.  Weiß gerade nicht was du mit V-Standby meinst
Gruß Uwe

UweR55, 2021-06-14:
Hallo Thomas, habe es gefunden :))  auf der Platine 4 von links mit dem linken oberen Pin verbinden
Nehme an, alle anderen Pos.  auf der Klemmleiste mit den ATX Netzteil - Anschlüssen belegen.

AMPrO-3D, 2021-06-15:
Genau, so meinte ich! Ja der Rest des ATX-Steckers sollte an den entsprechenden Stellen angeschlossen sein. Dadurch kannst du Testen, ob du das Netzteil Hochfahren kannst, und gleichzeitig ob ein Kurzschluss vorhanden ist

AMPrO-3D, 2021-06-15:
Aber es darf halt sonst nix draufgesteckt sein also weder Treiber noch Teensy noch Motoren

UweR55, 2021-06-15:
Morgen Thomas, Danke werde es so ausprobieren
Gruß....

AMPrO-3D, 2021-06-15:
Halt mich gerne auf dem laufenden wies bei dir funktioniert

UweR55, 2021-06-16:
Ok, werde ich machen

UweR55, 2021-06-21:
Hallo Thomas, habe das jetzt mal die Platine wie auf den Fotos verkabelt.
Was für ein Kabel lege ich vom V-Standby zum oberen linken Pin vom Teensy um das
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
anlaufen zu testen
Da ist ja noch das zweiadrige Kabel mit dem Schalter. Wenn ich den betätige läuft das Netzteil an.
Was mache ich mit dem. Muss der ausgeschaltet bleiben??
Gruß Uwe

AMPrO-3D, 2021-06-21:
An V-Standby hätte der Lila draht des ATX steckers hingehört. Dies ist aber bei dir nicht mehr notwendig den kannst du weglassen. Der Grüne Draht des ATX-Netzteils muss aber noch an den V-Controll angeschlossen werden. du kannst mal versuchen, das Grüne Kabel an einen der Masse anschlüsse zu halten, dann müsste das Netzteil auch an gehen

UweR55, 2021-06-21:
Thomas, ich habe ein lila Kabel aus dem ATX neu angeschlossen und verlegt; siehe
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
Fotos
Da messe ich auf Masse 5V, ist das ok ??
Wenn ok, dann kann ich es ja an V- Standby anklemmen

AMPrO-3D, 2021-06-21:
Ja genau. Wichtiger ist aber die Grüne Leitung

UweR55, 2021-06-22:
Hallo Thomas, jetzt habe ich endlich alle Kabel verlegt :))
Ich hoffe richtig.
Jetzt könnte ich ja zum Test ein separates Kabel vom V-Standby zum oberen linken Pin vom Teensy zum Anlauftest legen
Schau Dir noch mal die Fotos im Anhang an,
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
 ob das so OK ist.
Gruss....

AMPrO-3D, 2021-06-22:
NICHT EINSCHALTEN!!!

AMPrO-3D, 2021-06-22:
Ich habe mich in meinem ersten Post verschrieben. Es geht hier immer um den V-Controll Anschluss. Den Grünen. Der Lilane ist total egal, mit dem nix machen. Die Brücke was du machen solltest muß auf das Grüne Kabel nämlich das V Controller und auf den Pin am Teensy Sockel der Rest würde passen

UweR55, 2021-06-22:
Habe das jetzt verändert, Brücke geht jetzt vom grünen Kabel zum Teensy.
Soll das lila Kabel angeklemmt bleiben, oder abziehen?
Habe noch mal 2 Fotos vom letzten geänderten Stand angehängt
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

Gruss....

AMPrO-3D, 2021-06-22:
Wie gesagt, was mit dem Lila Kabel passiert ist egal, weil das durch die Änderung mit den Widerständen ohnehin ins leere läuft. Der Rest sollte so passen, kannst mal einschalten

UweR55, 2021-06-23:
OK Danke, werde ich heute Nachmittag mal ausprobieren.
Gruss...

UweR55, 2021-06-23:
Morgen Thomas, habe es ausprobiert, also den grünen mit dem oberen vom Teesy verbunden, läuft aber nicht an
Am grünen liegen 1,5V an, an den anderen Anschlüssen der Klemmleiste liegen 0 Volt an, außer beim Lila da liegen 5V an.
Was kann es sein ??
Gruß...

UweR55, 2021-06-23:
Thomas, mir ist noch was aufgefallen in REV 3, ist das richtig mit  "+" an 1 ( Masse )
Das hat ja jetzt mit meinem Problem nichts zu tun, vielleicht ist es ja so richtig
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

UweR55, 2021-06-23:
Thomas, ich habe jetzt, wie du mal beschrieben hast, den grünen an Masse gehalten, da ist das Netzteil angelaufen
Aber an der Teensy Leiste, am oberen linken Pin geht nichts
Was heißt das jetzt ? :)

UweR55, 2021-06-23:
Thomas, hatte nicht gewusst, das du mit Pin oben links die Rückseite der Platine meinst.
Da ist lt. Schaltplan ja der "GND". Da hat es funktioniert !! :))
Kann ich jetzt die 7 Treiber und den Teensy aufstecken oder ist  da noch was zu beachten??
Gruß...

AMPrO-3D, 2021-06-24:
🤣 Freut mich das du meinen Denkfehler gefunden hast. Ich hab im Layout nachgesehen, da ist alles Spiegelverkehrt... Aber so passt ja jetzt alles. Was du noch mache könntest, wäre sicher heißt Halter noch mal an allen Anschlüssen zu GND Spannung zu messen und zu überprüfen ob das mit dem Text auf dem Board über einstimmt. Also 3V3 die 5V und die 12V. Dann solltest du die Komponenten aufstecken können

UweR55, 2021-06-24:
Danke, werde das testen :)
Gruss....

UweR55, 2021-06-24:
Hallo Thomas, was ich so messen konnte zum testen, könnte ok sein (super sicher bin ich mir da nicht)   :)
Ich habe die Bauteile jetzt mal aufgesteckt, aber noch keine Spannung drauf gelegt.
Schau bitte noch mal drüber, vor allem schau dir mal die Motorentreiber an. Ich hoffe das die vom Typ O
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
k sind.
Gruß Uwe

UweR55, 2021-06-24:
Noch ein Bild von der Treiberbestellung und Beschreibung
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

AMPrO-3D, 2021-06-25:
Kaan es sein, dass du übersehen hast die Bilder anzuhängen?

UweR55, 2021-06-25:
Hallo Thomas, die Bilder sind bei mir sichtbar
Hänge noch mal Bilder an; Gruß....
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

UweR55, 2021-07-04:
Hallo Thomas,
- V27 MotionController Software stürzt sofort
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
 ab beim Klicken auf "Verbinden mit Motioncontroller
- die Treibermodule werden sehr heiß, musste alles außer Betrieb nehmen
- die Robotermotore machen alle sonderbare Geräusche, sind dauern am fibrieren
- was kann ich machen bzw. was ist falsch, Software ist intalliert

UweR55, 2021-07-04:
Die Software hat mir mein Sohn aufgespielt, ist Informatiker, das sollte ok sein

UweR55, 2021-07-04:
Ich habe nur die Achse 1   eingesteckt und ein mini Video gemacht
Der Treiber wird in der kurzen Zeit schon heiß, keine Ahnung was da zu machen ist

https://user-images.githubusercontent.com/85453410/124394228-d186ac00-dcfe-11eb-97ad-52fc78aa9e10.mp4

AMPrO-3D, 2021-07-05:
Läuft auf dem Teensy schon die Firmware?

Die Größen Motoren ziehen relativ viel Strom. Das die Treiber sich etwas erwärmen ist normal. Du kannst aber mal in der Firmware den Strom des MotorA etwas nach unten stellen und schauen ob der Treiber dann weniger warm wird

UweR55, 2021-07-05:
Hallo Thomas,
"Firmware" ist hochgeladen. Danke für den Tipp mit den Motoren. Hast Du eine Idee, warum die Motion C. Software
sich einfach schließt/abstürzt, sobald ich verbinden will mit dem Controller?

Gruß Uwe

elektrofreak86, 2021-07-08:
Hi,

Das würde mich auch interessieren. Stürzt bei mir auch ab sobald ich auf Verbinden Klicke.
Hier nochmal die Log Datei
[hs_err_pid9040.log](https://github.com/AMPrO-3D/Roboterarm/files/6786539/hs_err_pid9040.log)

Gruß
Sven

AMPrO-3D, 2021-07-12:
@elektrofreak86 @UweR55

Schreibt mich bitte mal unter dieser Email Adresse an:

thomas.reiter@ampro3d-gmbh.com

Dann können wir uns bei Gelegenheit 0er Zoom zusammen schließen und die Fehler suchen warum die Software abstürzt.

Tobismile, 2022-01-04:
Hey Leute,

Ist zwar schon eine Weile her, aber mich würde auch interessieren, ob ihr das Problem mit dem Abstürzen der Software gelöst bekommen habt. Habe leider das selbe Problem.
Gruß Tobi G.

elektrofreak86, 2022-01-04:
Hi, nein leider nicht, war da nicht mehr dran, hatte zu viel andere Projekte, aber an einer Lösung bin ich immer ich sehr interessiert GrußSven--Diese Nachricht wurde von meinem Android Mobiltelefon mit GMX Mail gesendet.Am 04.01.22, 14:55 schrieb Tobismile ***@***.***>:

  Hey Leute,
  Ist zwar schon eine Weile her, aber mich würde auch interessieren, ob ihr das Problem mit dem Abstürzen der Software gelöst bekommen habt. Habe leider das selbe Problem. Gruß Tobi G.
  —Reply to this email directly, view it on GitHub, or unsubscribe.Triage notifications on the go with GitHub Mobile for iOS or Android. You are receiving this because you were mentioned.Message ID: ***@***.***>

UweR55, 2022-01-04:
Hallo Leute,
habe auch Probleme mit der Software bzw mit der Platine. Hatte meine
Platine im Oktober 2021 an den Herrn Thomas Reiter auf dessen Wunsch
geschickt, habe aber seit dem nie mehr was von ihm gehört. Auch auf
mehrmaliges Anschreiben keine Reaktion mehr.
Es ist, als wäre er ausgewandert :))
Die Platine ist ja immer noch mein Eigentum!!
Das Projekt war interessant,  zwar elektrisch nicht ausgereift, aber halt
mal was einen fordert.
Mal sehen, wie es weitergeht.

elektrofreak86 ***@***.***> schrieb am Di., 4. Jan. 2022,
14:58:

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

AMPrO-3D, 2022-01-04:
Guten Abend,

nein ich bin nicht ausgewandert xD

deine Platine habe ich mir angeschaut, da habe ich keine Fehler gefunden. Ich hab mir dann nochmal deine Treiber angeschaut, und festgestellt, das deine Jumper-Config auf der unterseite des Treibers falsch sein könnte. Als du hier mal ein Bild davon gepostet hast, habe ich die Kurschlussbrücke nicht als solche erkannt, und dachte, der Jumper wäre unterbrochen.

Wenn der Jumper gebrückt ist, geht der Treiber in den Standalone-Modus und ist somit logischerweise nicht per SPI ansprechbar, was das Problem bei dir war.

Ich kann nur hoffen, dass das das einzige Problem war, warum deine Platine nicht funktioniert hat, ausprobieren kann ich das gerade nicht, weil ich kein unbenutztes ATX-Netzteil da habe.

Warum die Software nicht funktioniert weiß ich nach wie vor nicht, mir ist aber auch klar, das die Software mehr als nur ein paar Bugs hat. Für diese Software werde ich mittelfristig keine Zeit haben (nach dem ich  Uwes' Platine in meinem Weihnachtsurlaub angeschaut habe). Wenn sich jemand findet, der sich die Software mal anschauen möchte, helfe ich da natürlich wo ich kann.

@UweR55 Deine Platine geht morgen zur Post

UweR55, 2022-01-06:
Hallo Thomas,
Platine ist angekommen.
Danke für das kleine Geschenk:))
Was muss ich denn jetzt machen hinsichtlich der Jumper.
Und wo finde ich die auf der Platine
Gruß Uwe Ries

AMPrO 3D ***@***.***> schrieb am Di., 4. Jan. 2022, 18:04:

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

AMPrO-3D, 2022-01-06:
@UweR55 hab ich schon gemacht ;-)

Jetzt müsstest du die Treiber über Spi wieder konfigurieren können

Tobismile, 2022-01-11:
Abend Zusammen,
Ich hab es tatsächlich hinbekommen, das sich das Programm mit dem Controller verbindet juhu :D
Dafür müsst ihr nur im lib Ordner des MotionController V27 die jssc java Datei mit der neuen Version (Link) austauschen und die neue Version so wie die alte umbenennen. (Also jssc-2.9.4 -> jssc)
https://github.com/java-native/jssc/releases/download/v2.9.4/jssc-2.9.4.jar

Tobismile, 2022-01-11:
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

Thread 10 (2022-02-04):

Zahnriemenlänge bei den "openloop-Pulleys"

JoeBerlin69, 2022-02-04:
Liebes AMPrO-Team,
ich baue gerade den Roboterarm nach. Wie Ihr bereits erwähnt hat gestaltet sich die Zahnriemenversorgung des Originalbauvorschlags als unlösbar. Schön, dass ihr die "open-loop"-Lösung vorgeschlagen habt.
Mir ist jetzt beim Zusammenbau von Achse 1 und 2 nun nicht klar was die exakte Länge eines offenen Zahnriemens sein muss. Man kann die neuen Open-Loop-Pulleys nur mit riesigem Aufwand  wieder entfernen um den Zahnriemen anzupassen.
Außerdem ist mir nicht ganz klar in welcher Stellung Axis2Pulley angebracht werden muss. Da gibt es im Grunde 4 Möglichkeiten.
Vielleicht kann mir da jemand helfen, der mit der Open-Pulley-Variante gearbeitet hat. Günstiger wäre es, wenn man von außen an die  "Zahnriemen-Klemm-Schlaufe" herankäme.

Herzliche Grüße und Vielen Dank
Jörg

Thread 11 (2022-10-07):

Platine

Cedi00123, 2022-10-07:
Hallo,

ich habe ein Problem mit der Platine.
Es ist alles fertig angeschlossen das Netzteil liefert die erforderlichen Spannungen, die Motortreiber sind die Richtigen, der Tennsy bekommt Strom und ist richtig Programmiert.
Trotzdem Bewegen die Motoren sich nicht und die Schrittmotortreiber werden nicht mal warm. Man kann die Motorspannung einstellen.

Ich hoffe mir kann jemand Helfen.

AMPrO-3D, 2022-10-10:
Hallo Cedi,

Dann sind deine Treiber vermutlich in der Falschen Konfiguration, Auf der Unterseite haben die einen kleinen gelöteten Jumper, mit dem man den Betriebsmodus einstellen kann. Den musst du umstellen, dann sollte es funktionieren

Cedi00123, 2022-10-10:
Sowie ich das sehe ist der Treiber richtig konfiguriert.

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

Cedi00123, 2022-12-11:
Es Funktioniert leider immer noch nicht. Ich habe versucht den Roboter über den Seriellen Monitor anzusteuern und der Teensy Antwortet auch aber bewegen tut sich nix.

Thread 12 (2022-12-28):

fatal error: TMC2130Stepper_REGDEFS.h: No such file or directory compilation terminated.

Th199403, 2022-12-28:
hab die firmeware geöffnet und  wollte sie hochladen und dan kam der fehler fatal error: TMC2130Stepper_REGDEFS.h: No such file or directory
compilation terminated.

da fehlt anscheind eine datei?

SoulL3Zz, 2023-01-29:
Du musst diese Bibliothek in Arduino installieren.
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

Thread 13 (2023-08-31):

TMC2130 Alternative

j-wittke, 2023-08-31:
Hallo,

da der Roboterarm schon etwas älter ist, gibt es ein Problem, auf welches ich aktuell noch keine Antwort gefunden habe:
Der Schrittmotortreiber „TMC2130“ ist nicht mehr verfügbar. Dadurch bedingt habe ich den „TMC2209“ als Alternative herangezogen, da dieser der einzige TMC-Schrittmotortreiber ist, der aktuell verfügbar ist. Ich habe bereits rudimentär überprüft, ob ein Zusammenbau mithilfe dieses Treibers möglich wäre.
Die Unterschiede haben mich aufgrund fehlender Berechnungen etwas zweifeln lassen: Besonders geht es hier um die Frage, inwiefern  „Motor-Supply-Voltage“ und RDSon eine Installation behindern würden, da hier Unterschiede zwischen TMC2130 und TMC2209 bestehen. ([Quelle](https://learn.watterott.com/silentstepstick/comparison/))
Außerdem wird die Konfiguration/ das Interface mit dem TMC2130 über SPI geregelt, was bei dem TMC2209 nur über den Step/Dir und/oder UART-Modus möglich ist – ist es trotz dieses Unterschiedes möglich, den TMC2209 zu verwenden?

Hat irgendwer bereits Erfahrungen mit einem neueren Treiber gemacht oder hätte eine Ahnung, ob man den TMC2130 mit dem TMC2209 ersetzen könnte?

Closed 2023-10-24.

Thread 14 (2025-04-24):

Grüße aus Madrid! Maker-Fragen zu deinem Skyentific-Roboterarm 🤖🛠️

nvarona, 2025-04-24:
Hallo Andreas,

ich hoffe, dir geht’s gut und du bist umgeben von spannenden Projekten und dem angenehmen Geruch frisch gedruckten PLAs!

Mein Name ist Natxo Varona und ich schreibe dir aus Madrid (Spanien). Ich bin ein Maker mit einer Leidenschaft für Robotik, Drohnen, 3D-Druck und allem, was nach Mikroelektronik und Schrauben riecht. Momentan baue ich einen 6-DOF-Roboterarm mit NEMA-Motoren. Nach dem Durchstöbern einiger Optionen (wie dem AR4 von Annin Robotics oder anderen Open-Source-Projekten) bin ich auf den Skyentific-Arm gestoßen... und es war Liebe auf den ersten Blick! 😍

Ich habe direkt mit dem 3D-Druck begonnen und bin dann in die Elektronik eingetaucht – und wow, das Projekt hat ja schon ein paar Jahre auf dem Buckel. Inzwischen hat sich in der Maker-Welt einiges getan (danke an die Chinesen für günstige und spannende Elektronikkomponenten 😄). Also habe ich mich auf die Suche gemacht, ob jemand diesen Arm ebenfalls nachgebaut hat – und so bin ich auf dich gestoßen! Besonders, weil ich nach einer Greiferlösung gesucht habe, und dein Aufbau einfach klasse ist.

Ich habe den ursprünglichen Entwickler im Forum angeschrieben (Link sende ich dir gerne), aber leider nie eine Antwort bekommen. Deshalb dachte ich: vielleicht kann mir Andreas weiterhelfen?

Wenn es für dich okay ist, hätte ich ein paar Fragen – versprochen, ich halte mich kurz:

Ich habe dir ein Diagramm meiner geplanten Elektronik für den Arm angehängt, inklusive deines Greifers. Was meinst du – klingt das vernünftig?

Du hast im Video einen TPU-Greifer gezeigt, aber ich konnte die STL-Dateien dazu nicht auf deinem GitHub finden. Wärst du so nett, sie zu teilen?

Die Originalversion verwendet Kohlefaserplatten. Ich habe aber noch nie mit PETG mit Faseranteil gedruckt. Meinst du, meine Prusa MK3S schafft das, wenn ich 100 % Infill einstelle?

Wurde der Roboterarm seitdem weiterentwickelt? Oder kennst du jemanden, der eine verbesserte Version gebaut hat?

Und zu guter Letzt: In deinem YouTube-Video sagtest du, dass du noch ein paar PCBs übrighast, die du verschenken würdest. Gibt es da vielleicht noch eine übrig für mich? 😅

Ich möchte dich nicht mit Fragen überrollen – einfach nur ein riesiges Dankeschön für deine großartige Arbeit! Sie hat mich wirklich inspiriert. Ich würde mich sehr freuen, wenn wir in Kontakt bleiben könnten.

Viele Grüße aus Madrid
