AMPrO-3D/Roboterarm/Elektronik/Schaltplan.pdf

# GND M1A DIAG1 M2A M1B M2B

# VREF CFG0/SD0 B4

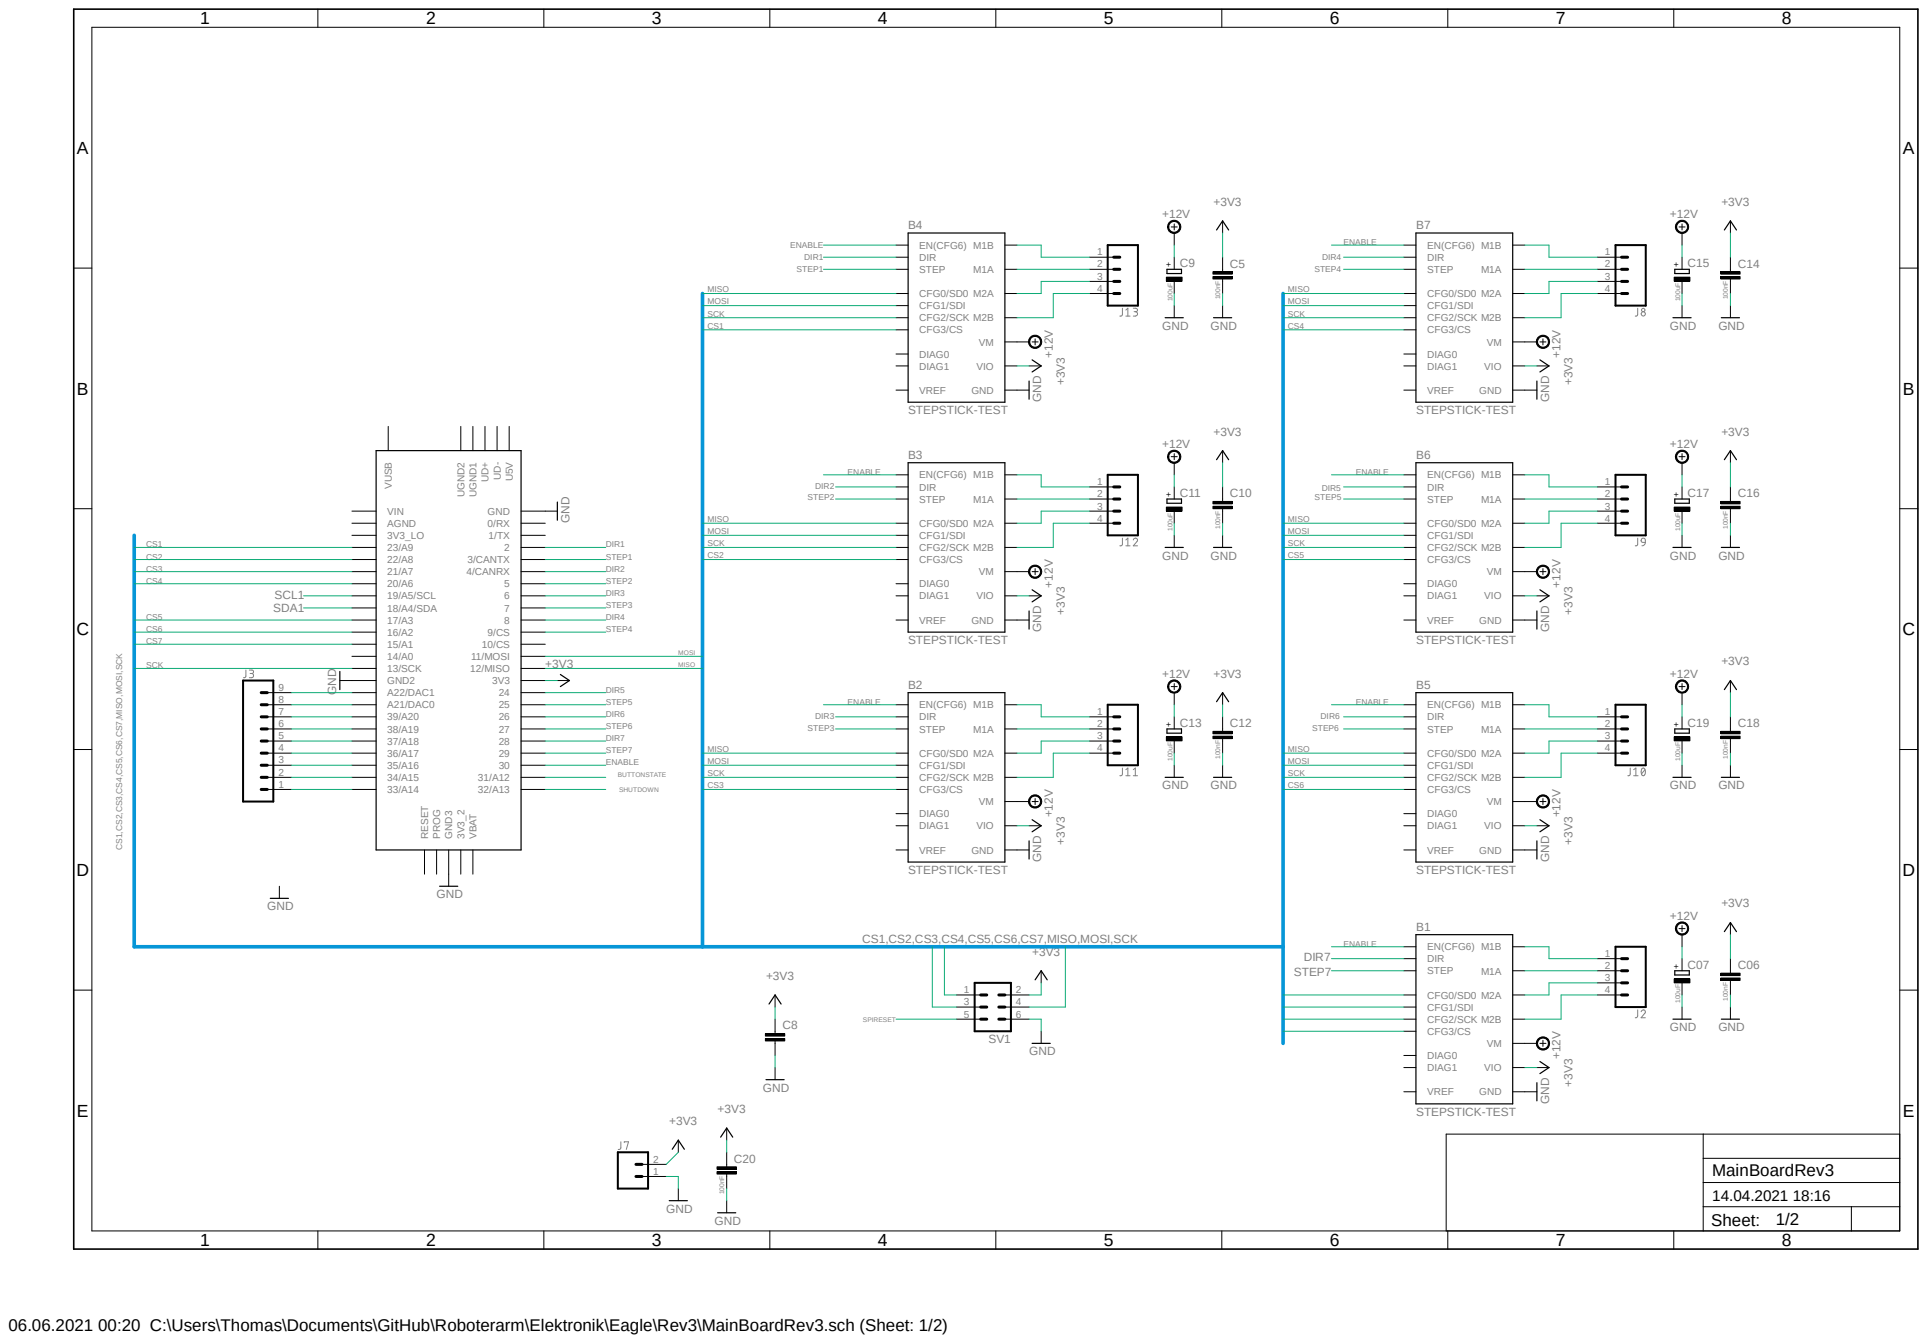
[picture p23: page 1]

STEP CFG1/SDI CFG2/SCK CFG3/CS DIAG0 EN(CFG6) VM
DIR

MOSI MOSI

9 CS1,CS2,CS3,CS4,CS5,CS6,CS7,MISO,MOSI,SCK CS¹,CS²,CS³,CS⁴,CS⁵,CS⁶,CS⁷,MISO,MOSI,SCK

06.06.2021 00:20 C:\Users\Thomas\Documents\GitHub\Roboterarm\Elektronik\Eagle\Rev3\MainBoardRev3.sch (Sheet: 1/2)

# GND 12k GND

A

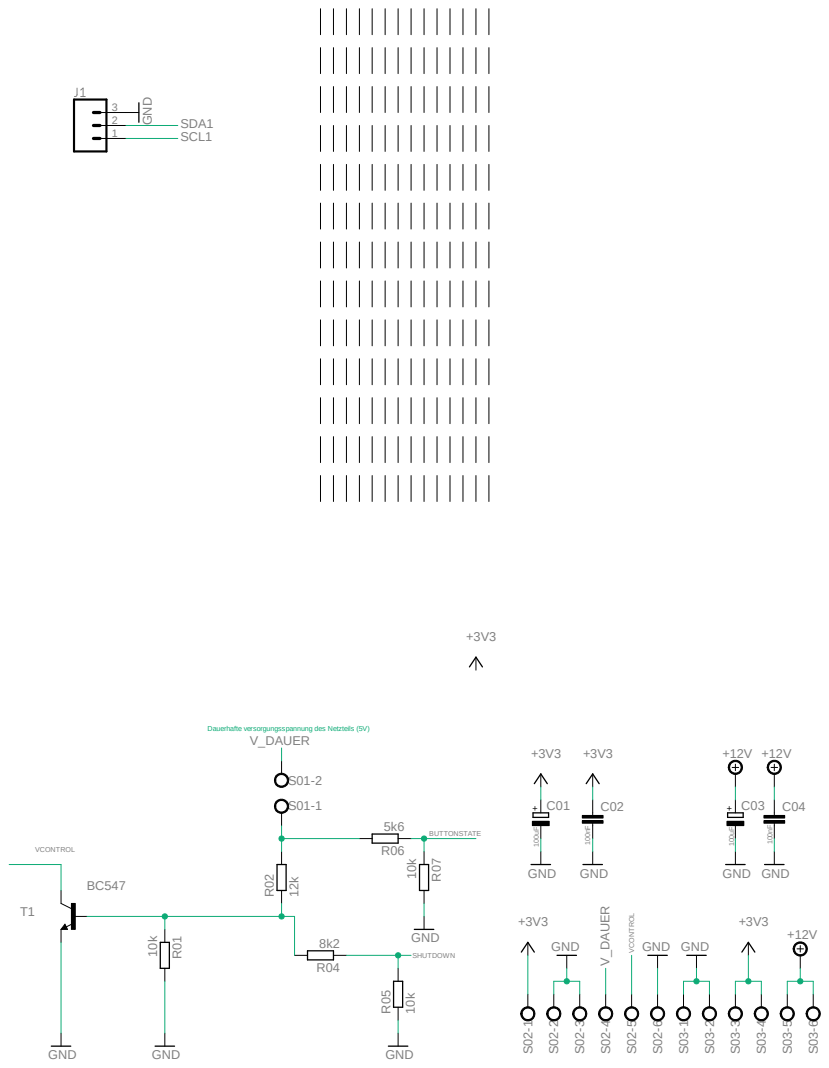
[picture p24: page 2]
06.06.2021 00:20 C:\Users\Thomas\Documents\GitHub\Roboterarm\Elektronik\Eagle\Rev3\MainBoardRev3.sch (Sheet: 2/2) ¹⁰⁰uF; GND; C04 S⁰²⁻¹; S⁰²⁻²; S⁰²⁻³; S⁰²⁻⁴; S⁰²⁻⁵; S⁰²⁻⁶; S⁰³⁻¹; S⁰³⁻²; S⁰³⁻³; S⁰³⁻⁴; S⁰³⁻⁵; S⁰³⁻⁶; R⁰¹; R⁰²; R⁰⁵; R⁰⁷; VCONTROL; SHUTDOWN; SDA1; SCL1; V_DAUER; BUTTONSTATE; Sheet:; MainBoardRev3

Dauerhafte versorgungsspannung des Netzteils (5V)
V_DAUER
