AMPrO-3D/Roboterarm/Zusatzteile/Greifer/Zeichnungssatz.pdf

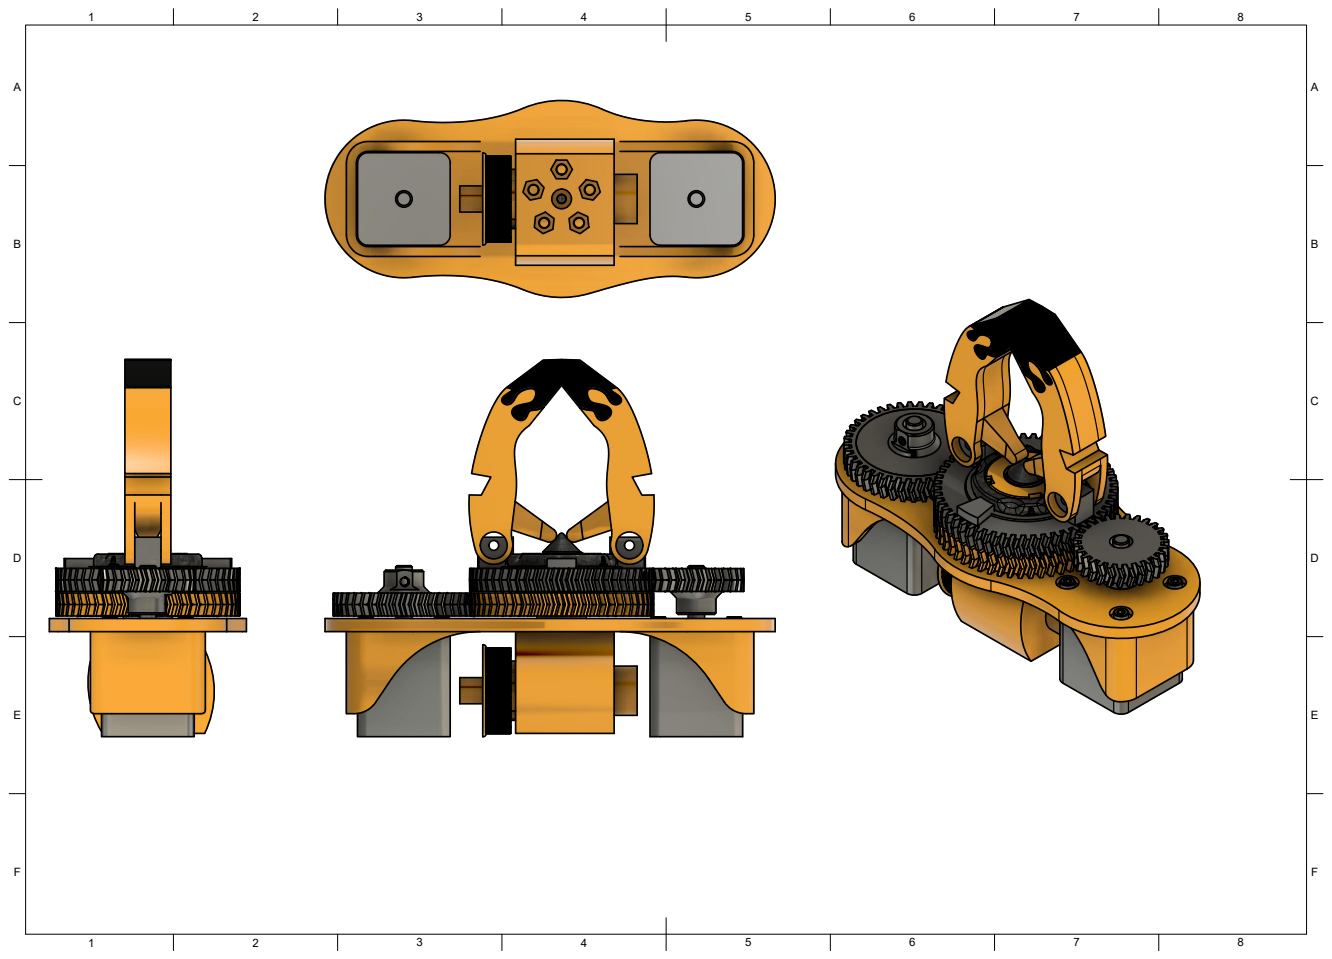
[picture p25: page 1]
8 BCDEF; ABCDEF

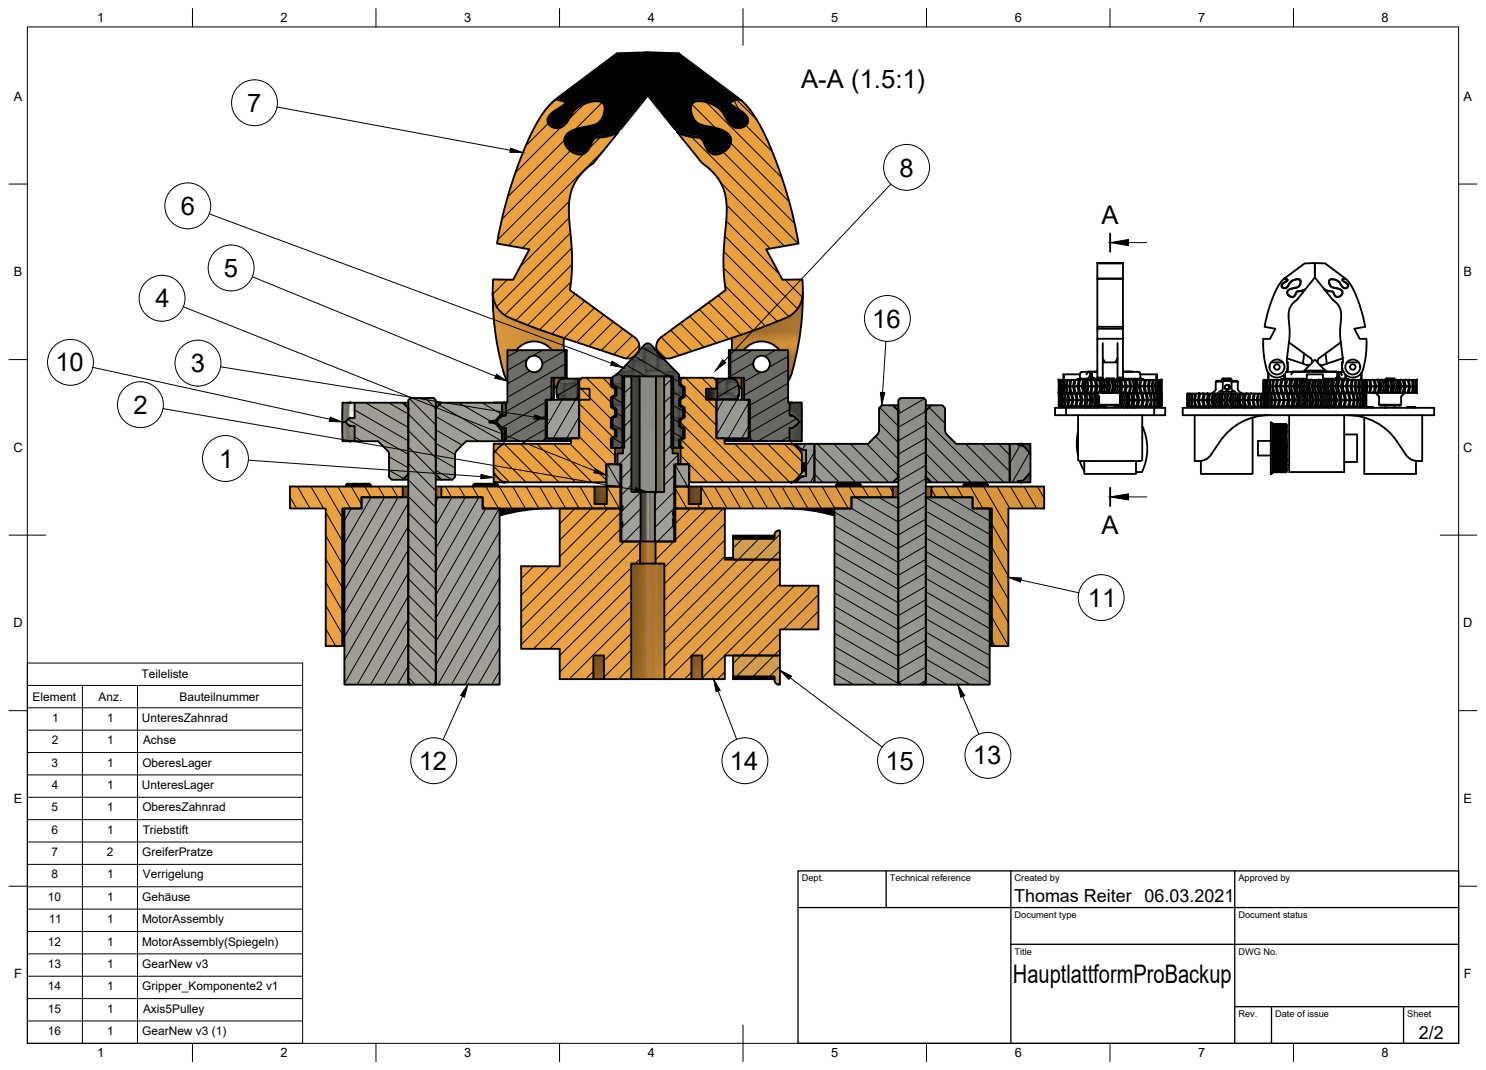
[picture p26: page 2]
Dept.; Technical reference; Created by; Approved by; Document type; Document status; Title; DWG No.; Rev.; Date of issue; Sheet; Thomas Reiter; GearNew v3; Gripper_Komponente2 v1; GearNew v3 (1)
