AMPrO-3D/Roboterarm/Grundstellung.pdf

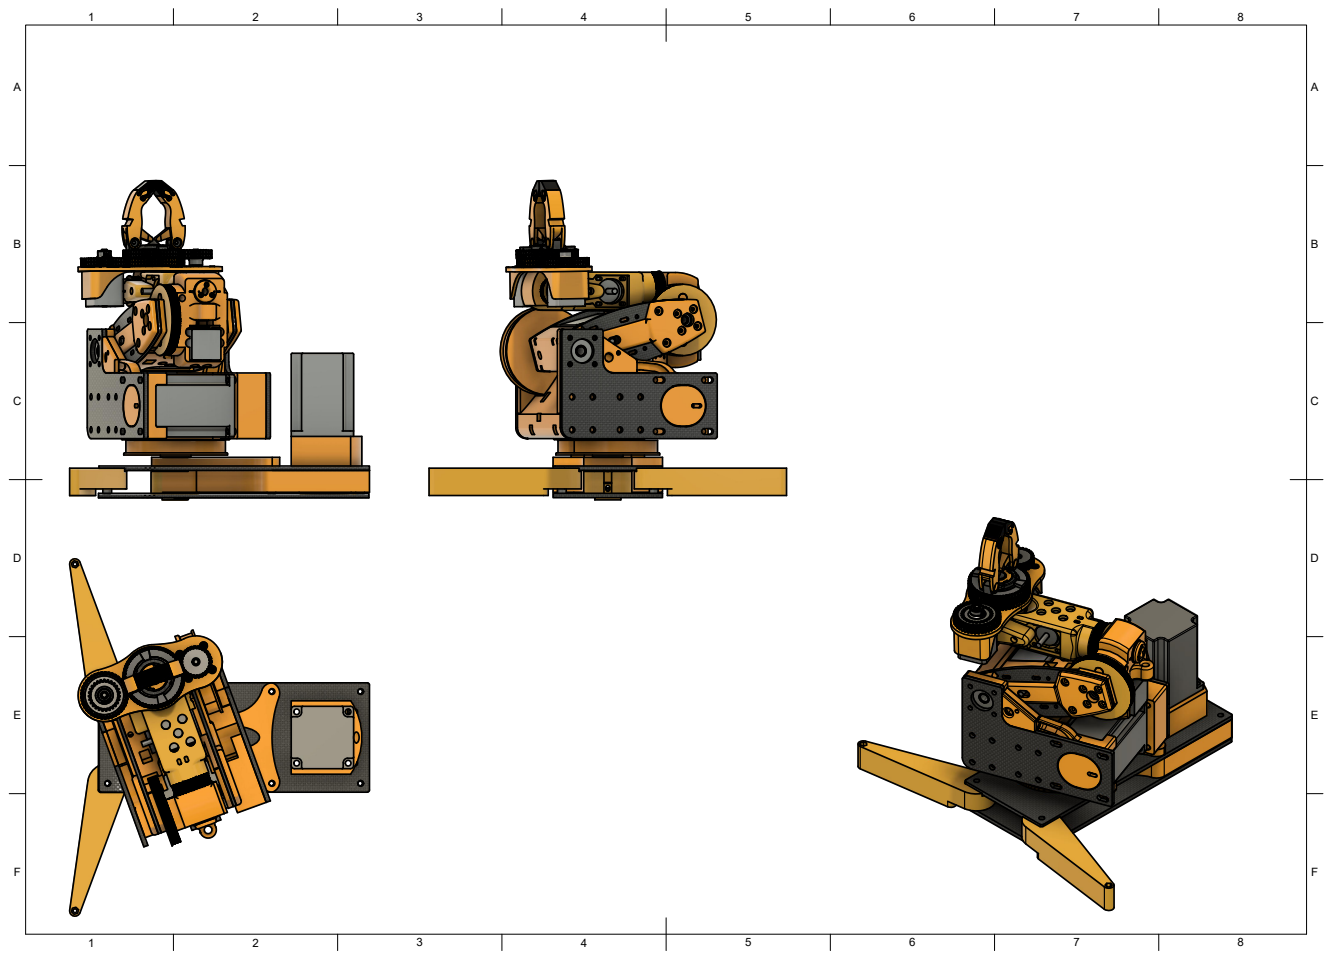
[picture p27: page 1]
8 BCDEF; ABCDEF
