AMPrO-3D/Roboterarm/Elektronik/Eagle/Rev1/MainBoard.brd

## EAGLE design Elektronik/Eagle/Rev1/MainBoard.brd (2021-03-06, an earlier design)

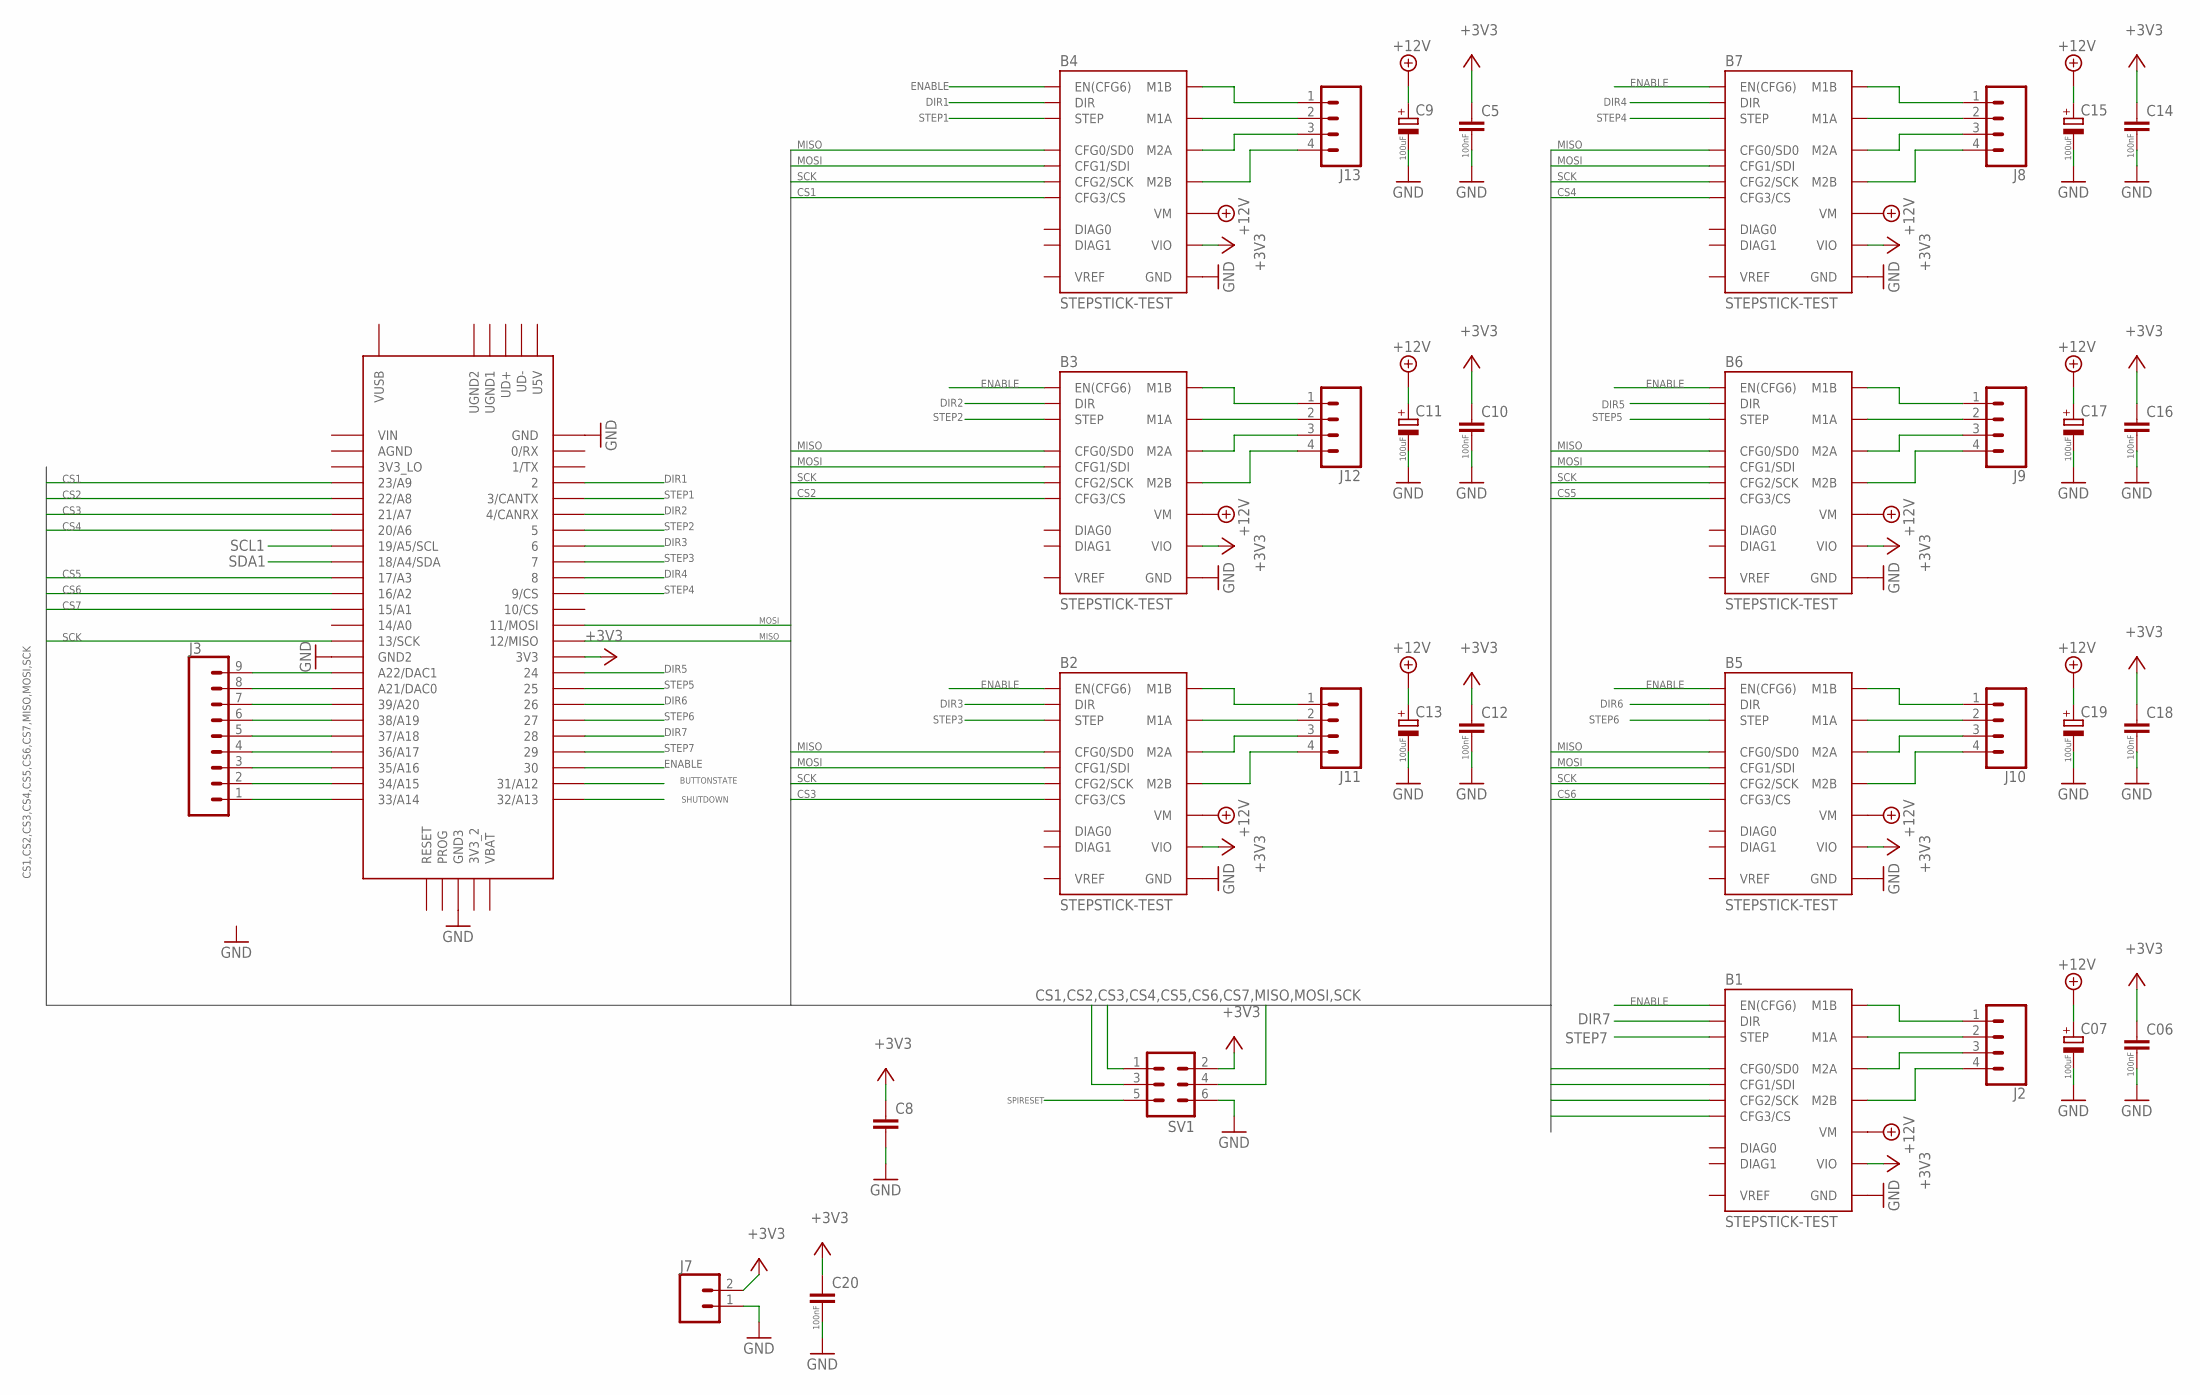
[picture p28: schematic MainBoard.sch, sheet 1, <b>Schrittmotorsteuerung</b> <br> Hier wird die Schaltung f…]

Parts:
B1, B2, B3, B4, B5, B6, B7: STEPSTICK-TEST
C5, C06, C10, C12, C14, C16, C18, C20: 100nF; C050-024X044
C07, C9, C11, C13, C15, C17, C19: 100uF; E2,5-6
C8: C-EU050-024X044; C050-024X044
J2, J8, J9, J10, J11, J12, J13: CONN_041X04_NO_SILK; 1X04_NO_SILK
J3: CONN_09LONGPADS; 1X09_LONGPADS
J7: CONN_02PTH3; 1X02_LONGPADS
SV1: MA03-2
U$1: TEENSY_4.1

Connections:
+3V3: B1.VIO, B2.VIO, B3.VIO, B4.VIO, B5.VIO, B6.VIO, B7.VIO, C5.1, C06.1, C8.1, C10.1, C12.1, C14.1, C16.1, C18.1, C20.1, J7.2, SV1.2, U$1.3V3; also elsewhere on the board
+12V: B1.VM, B2.VM, B3.VM, B4.VM, B5.VM, B6.VM, B7.VM, C07.+, C9.+, C11.+, C13.+, C15.+, C17.+, C19.+; also elsewhere on the board
BUTTONSTATE: U$1.31/A12; also elsewhere on the board
CS1: B4.CFG3 (CFG3/CS), U$1.23/A9
CS2: B3.CFG3 (CFG3/CS), U$1.22/A8
CS3: B2.CFG3 (CFG3/CS), U$1.21/A7
CS4: B7.CFG3 (CFG3/CS), U$1.20/A6
CS5: B6.CFG3 (CFG3/CS), U$1.17/A3
CS6: B5.CFG3 (CFG3/CS), U$1.16/A2
CS7: B1.CFG3 (CFG3/CS), U$1.15/A1
DIR1: B4.DIR, U$1.2
DIR2: B3.DIR, U$1.4/CANRX
DIR3: B2.DIR, U$1.6
DIR4: B7.DIR, U$1.8
DIR5: B6.DIR, U$1.24/A10 (24)
DIR6: B5.DIR, U$1.26/12 (26)
DIR7: B1.DIR, U$1.28
ENABLE: B1.EN (EN(CFG6)), B2.EN (EN(CFG6)), B3.EN (EN(CFG6)), B4.EN (EN(CFG6)), B5.EN (EN(CFG6)), B6.EN (EN(CFG6)), B7.EN (EN(CFG6)), U$1.30
GND: B1.GND@1 (GND), B1.GND@2 (GND), B2.GND@1 (GND), B2.GND@2 (GND), B3.GND@1 (GND), B3.GND@2 (GND), B4.GND@1 (GND), B4.GND@2 (GND), B5.GND@1 (GND), B5.GND@2 (GND), B6.GND@1 (GND), B6.GND@2 (GND), B7.GND@1 (GND), B7.GND@2 (GND), C5.2, C06.2, C07.-, C8.2, C9.-, C10.2, C11.-, C12.2, C13.-, C14.2, C15.-, C16.2, C17.-, C18.2, C19.-, C20.2, J7.1, SV1.6, U$1.GND, U$1.GND2, U$1.GND3; also elsewhere on the board
MISO: B1.NC/CFG0 (CFG0/SD0), B2.NC/CFG0 (CFG0/SD0), B3.NC/CFG0 (CFG0/SD0), B4.NC/CFG0 (CFG0/SD0), B5.NC/CFG0 (CFG0/SD0), B6.NC/CFG0 (CFG0/SD0), B7.NC/CFG0 (CFG0/SD0), SV1.1, U$1.12/MISO
MOSI: B1.CFG1 (CFG1/SDI), B2.CFG1 (CFG1/SDI), B3.CFG1 (CFG1/SDI), B4.CFG1 (CFG1/SDI), B5.CFG1 (CFG1/SDI), B6.CFG1 (CFG1/SDI), B7.CFG1 (CFG1/SDI), SV1.4, U$1.11/MOSI
unnamed: B1.M2B, J2.4
unnamed: B1.M2A, J2.3
unnamed: B1.M1A, J2.2
unnamed: B1.M1B, J2.1
unnamed: J3.1, U$1.33/A14
unnamed: J3.2, U$1.34/A15
unnamed: J3.3, U$1.35/A16
unnamed: J3.4, U$1.36/A17
unnamed: J3.5, U$1.37/A18
unnamed: J3.6, U$1.38/A19
unnamed: B2.M2B, J11.4
unnamed: B2.M2A, J11.3
unnamed: B2.M1A, J11.2
unnamed: B2.M1B, J11.1
unnamed: B3.M2B, J12.4
unnamed: B3.M2A, J12.3
unnamed: B3.M1A, J12.2
unnamed: B3.M1B, J12.1
unnamed: B4.M2B, J13.4
unnamed: B4.M2A, J13.3
unnamed: B4.M1A, J13.2
unnamed: B4.M1B, J13.1
unnamed: B5.M2B, J10.4
unnamed: B5.M2A, J10.3
unnamed: B5.M1A, J10.2
unnamed: B5.M1B, J10.1
unnamed: B6.M2B, J9.4
unnamed: B6.M2A, J9.3
unnamed: B6.M1A, J9.2
unnamed: B6.M1B, J9.1
unnamed: B7.M2B, J8.4
unnamed: B7.M2A, J8.3
unnamed: B7.M1A, J8.2
unnamed: B7.M1B, J8.1
unnamed: J3.7, U$1.39/A20
unnamed: J3.8, U$1.21/DAC0 (A21/DAC0)
unnamed: J3.9, U$1.A22/DAC1
SCK: B1.CFG2 (CFG2/SCK), B2.CFG2 (CFG2/SCK), B3.CFG2 (CFG2/SCK), B4.CFG2 (CFG2/SCK), B5.CFG2 (CFG2/SCK), B6.CFG2 (CFG2/SCK), B7.CFG2 (CFG2/SCK), SV1.3, U$1.13/SCK
SCL1: U$1.19/A5/SCL; also elsewhere on the board
SDA1: U$1.18/A4/SDA; also elsewhere on the board
SHUTDOWN: U$1.32/A13; also elsewhere on the board
SPIRESET: SV1.5
STEP1: B4.STEP, U$1.3/CANTX
STEP2: B3.STEP, U$1.5
STEP3: B2.STEP, U$1.7
STEP4: B7.STEP, U$1.9/CS
STEP5: B6.STEP, U$1.25/A11 (25)
STEP6: B5.STEP, U$1.27/A13 (27)
STEP7: B1.STEP, U$1.29

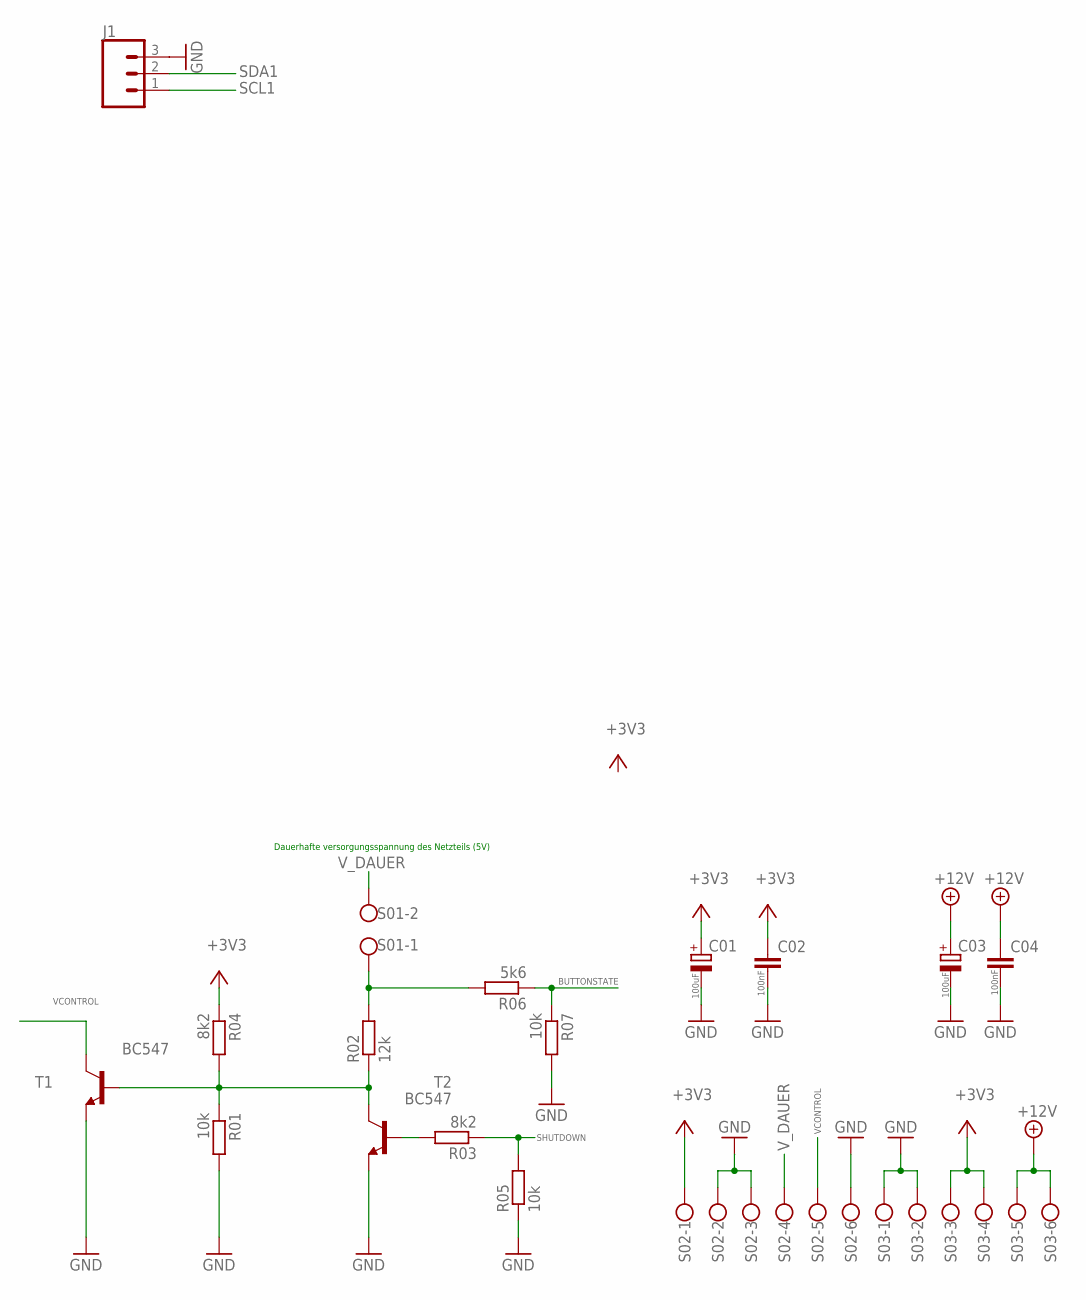
[picture p29: schematic MainBoard.sch, sheet 2, <b>Spannungsversorgung</b> <br> Hier wird das Powerup-Inter…]

Parts:
C01, C03: 100uF; E2,5-6
C02, C04: 100nF; C050-024X044
J1: CONN_03LONGPADS; 1X03_LONGPADS
R01, R05, R07: 10k; 0207/10
R02: 12k; 0207/10
R03, R04: 8k2; 0207/10
R06: 5k6; 0207/10
S01: W237-102
S02, S03: W237-6
T1, T2: BC547; TO92

Connections:
+3V3: C01.+, C02.1, R04.1, S02.1, S03.3, S03.4; also elsewhere on the board
+12V: C03.+, C04.1, S03.5, S03.6; also elsewhere on the board
BUTTONSTATE: R06.1, R07.1; also elsewhere on the board
GND: C01.-, C02.2, C03.-, C04.2, J1.3, R01.2, R05.1, R07.2, S02.2, S02.3, S02.6, S03.1, S03.2, T1.1 (E), T2.1 (E); also elsewhere on the board
unnamed: R01.1, R02.1, R04.2, T1.2 (B), T2.3 (C)
unnamed: R02.2, R06.2, S01.1
unnamed: R03.2, T2.2 (B)
SCL1: J1.1; also elsewhere on the board
SDA1: J1.2; also elsewhere on the board
SHUTDOWN: R03.1, R05.2; also elsewhere on the board
VCONTROL: S02.5, T1.3 (C)
V_DAUER: S01.2, S02.4

Notes on the sheet:
Dauerhafte versorgungsspannung des Netzteils (5V)

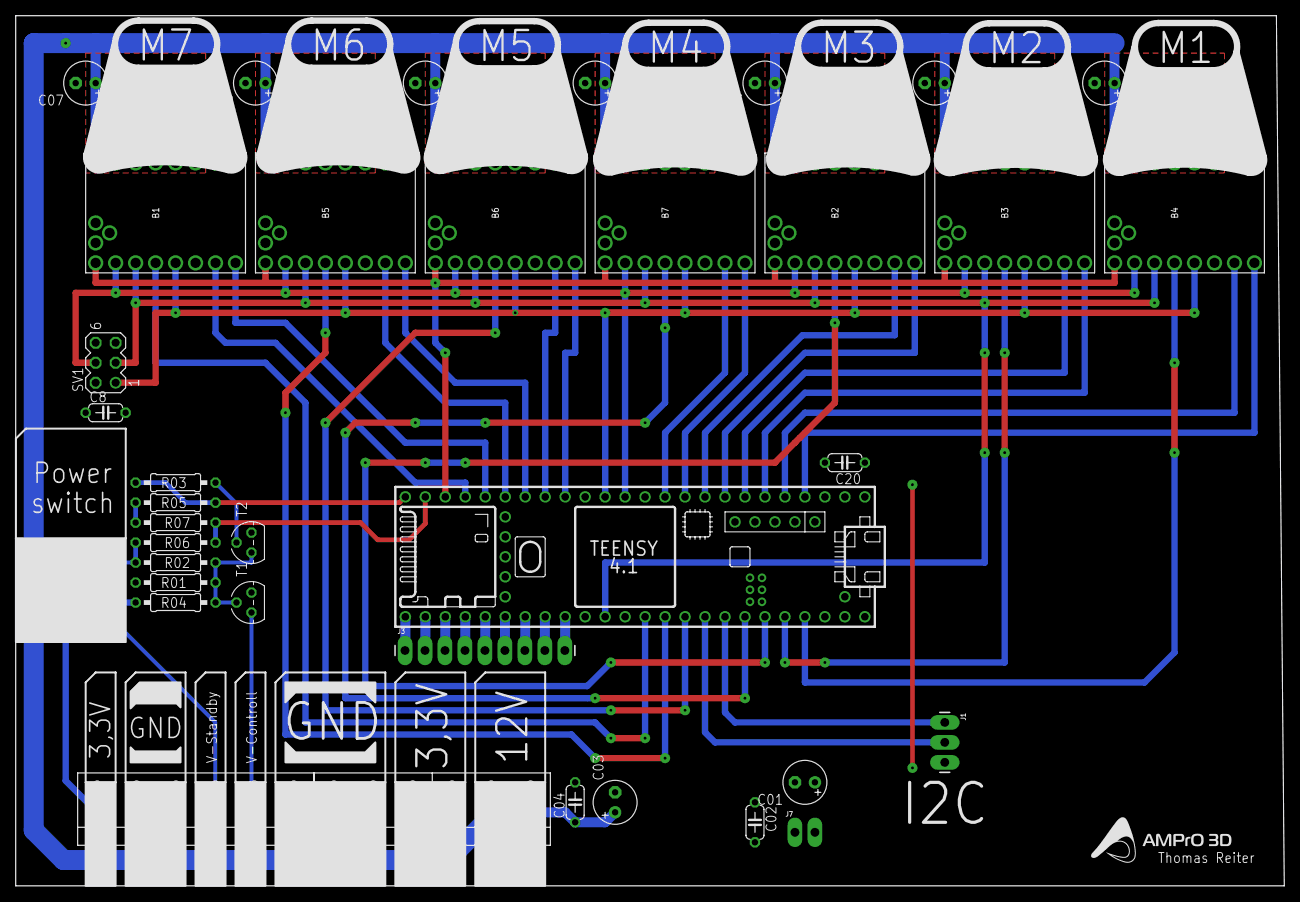
[picture p30: board MainBoard.brd from above]

Board: 2 copper layers, 161.3 x 110.6 mm, 51 parts (0 on the bottom side), 74 nets.
