AMPrO-3D/Roboterarm/Firmware/06_MultiMotorControll_V1/RegisterDefinition.h

#define PowerButtonPressed 10



#define SC_Handshake 1
#define SC_Shutdown 2
#define SC_Run 3


/*  Pin Konfiguration für Schrittmotortreiber
 * 
 * 
 */


#define DIR_PIN1    2
#define STEP_PIN1   3

#define DIR_PIN2    4
#define STEP_PIN2   5

#define DIR_PIN3    6
#define STEP_PIN3   7

#define DIR_PIN4    8
#define STEP_PIN4   9

#define DIR_PIN5    24
#define STEP_PIN5   25

#define DIR_PIN6    26
#define STEP_PIN6   27

#define DIR_PIN7    28
#define STEP_PIN7   29

//CS der Treiber

#define CS_PIN1     23

#define CS_PIN2     22

#define CS_PIN3     21

#define CS_PIN4     20

#define CS_PIN5     17

#define CS_PIN6     16

#define CS_PIN7     15


//EN für alle Stepper gemeinsam
#define EN_PIN    30
