AMPrO-3D/Roboterarm/(commit log)

2021-03-06 Zusatzteile eingefügt
    [Achse.stl, Basiselement.stl, GreiferPratze_2mal.stl, Motorhalterung.stl, Triebstift.stl, Verrigelung.stl]
2021-03-06 Weitere Uploads
    [Standoff.stl]
2021-04-03 Vergessenes nachträglich hochgeladen
    [Axis1Pulley_OpenLoop.stl, Axis2Pulley_OpenLoop.stl]
2021-04-14 Fehlerausbesserung dank elektrofreak86
    Beim Layouten der Rev2 Elektronik ist mir ein Fehler unterlaufen, worauf ich durch den User elektrofreak86 aufmerksam gemacht wurde. -> Vielen Dank nochmal an Ihn! Dies wurde in der Version Rev3 ausgebessert und die entsprechenden Gerber-Files hinzugefügt
    [MainBoard.brd, MainBoard.sch, MainBoardRev2.brd, MainBoardRev2.sch, MainBoardRev3.brd, MainBoardRev3.sch]
